orbierobot/orbierobot-firmware/hardware/v5/out/orbie_v5_body.top.png

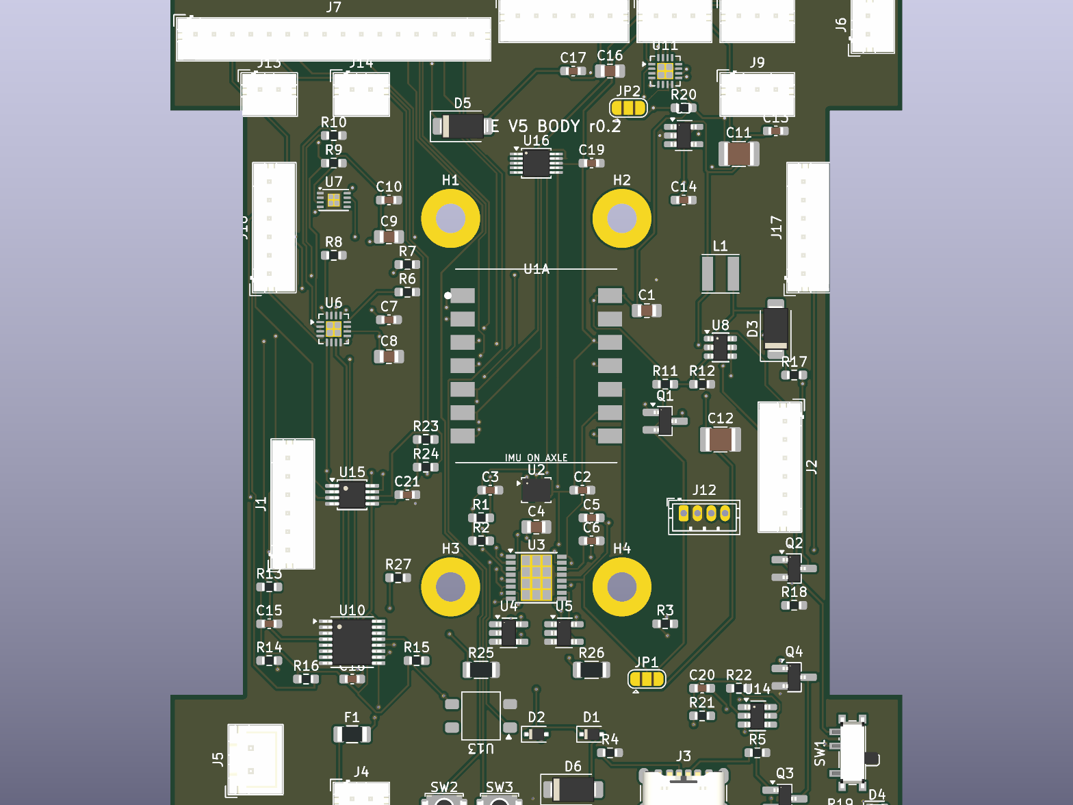
hardware/v5/out/orbie_v5_body.top.png
