orbierobot/orbierobot-firmware/hardware/v5/out/orbie_v5_dock.bottom.png

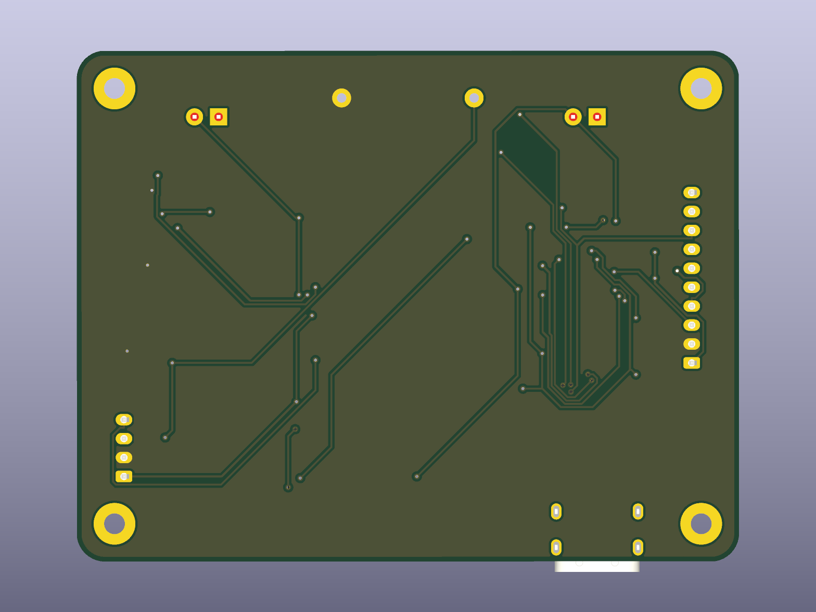
hardware/v5/out/orbie_v5_dock.bottom.png
