orbierobot/orbierobot-firmware/hardware/v5/out/orbie_v5_water.bottom.png

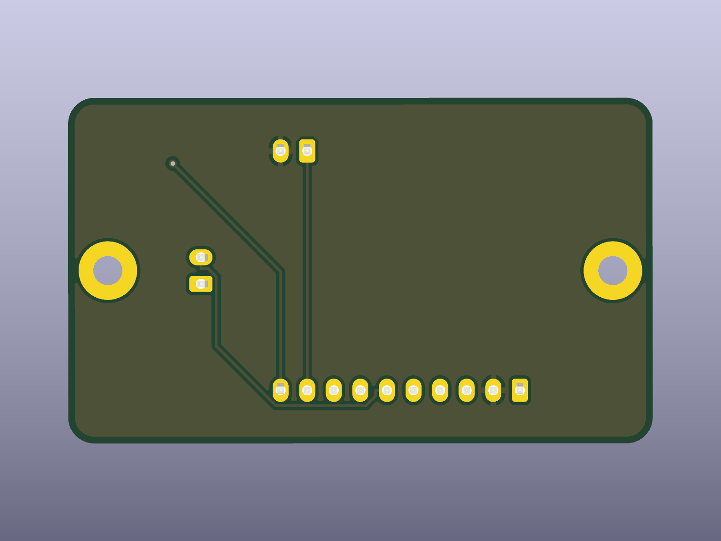
hardware/v5/out/orbie_v5_water.bottom.png
