orbierobot/orbierobot-firmware/hardware/v5/orbie_v5_dock_bom.csv

Ref | Value | Symbol | Footprint | Side | Description
U1A | XIAO_ESP32C3 D0-D6 | Connector:Conn_01x07_Pin | orbie_v5:XIAO_Castellated | F | XIAO ESP32-C3 left row
U1B | XIAO_ESP32C3 D7-D10,3V3,GND,5V | Connector:Conn_01x07_Pin | orbie_v5:XIAO_Castellated | F | XIAO ESP32-C3 right row
C1 | 10u | Device:C | Capacitor_SMD:C_0805_2012Metric_Pad1.18x1.45mm_HandSolder | F | capacitor
J1 | USB-C 5V in | Connector:USB_C_Receptacle_PowerOnly_6P | Connector_USB:USB_C_Receptacle_GCT_USB4125-xx-x_6P_TopMnt_Horizontal | F | USB-C 6P
R1 | 5k1 | Device:R | Resistor_SMD:R_0603_1608Metric_Pad0.98x0.95mm_HandSolder | F | resistor
R2 | 5k1 | Device:R | Resistor_SMD:R_0603_1608Metric_Pad0.98x0.95mm_HandSolder | F | resistor
D1 | SMAJ5.0A TVS | Diode:SMAJ5.0A | Diode_SMD:D_SMA | F
F1 | 3A | Device:Polyfuse_Small | Fuse:Fuse_1206_3216Metric | F
C2 | 22u | Device:C | Capacitor_SMD:C_1210_3225Metric_Pad1.33x2.70mm_HandSolder | F | capacitor
Q1 | AO3401A | Transistor_FET:AO3401A | Package_TO_SOT_SMD:SOT-23_Handsoldering | F | pad high-side switch
Q2 | AO3400A | Transistor_FET:AO3400A | Package_TO_SOT_SMD:SOT-23_Handsoldering | F | level shift
R3 | 10k | Device:R | Resistor_SMD:R_0603_1608Metric_Pad0.98x0.95mm_HandSolder | F | resistor
R4 | 100k | Device:R | Resistor_SMD:R_0603_1608Metric_Pad0.98x0.95mm_HandSolder | F | resistor
R5 | 0R05 1W | Device:R | Resistor_SMD:R_2512_6332Metric | F | resistor
R6 | 100k (pads dead) | Device:R | Resistor_SMD:R_0603_1608Metric_Pad0.98x0.95mm_HandSolder | F | resistor
R7 | 10k | Device:R | Resistor_SMD:R_0603_1608Metric_Pad0.98x0.95mm_HandSolder | F | resistor
R8 | 10k | Device:R | Resistor_SMD:R_0603_1608Metric_Pad0.98x0.95mm_HandSolder | F | resistor
TP1 | POGO PIN + (P50 spring) | Connector:TestPoint | TestPoint:TestPoint_THTPad_D2.0mm_Drill1.0mm | F | spring pin, 14 mm pitch
TP2 | POGO PIN - (P50 spring) | Connector:TestPoint | TestPoint:TestPoint_THTPad_D2.0mm_Drill1.0mm | F | spring pin
D2 | IR LED 940nm L | Device:LED | LED_THT:LED_D5.0mm | F | beacon lobe
R9 | 33R 1W | Device:R | Resistor_SMD:R_1206_3216Metric | F | resistor
Q3 | MMBT2222A | Transistor_BJT:MMBT2222A | Package_TO_SOT_SMD:SOT-23_Handsoldering | F | LED driver
R11 | 1k | Device:R | Resistor_SMD:R_0603_1608Metric_Pad0.98x0.95mm_HandSolder | F | resistor
D3 | IR LED 940nm R | Device:LED | LED_THT:LED_D5.0mm | F | beacon lobe
R10 | 33R 1W | Device:R | Resistor_SMD:R_1206_3216Metric | F | resistor
Q4 | MMBT2222A | Transistor_BJT:MMBT2222A | Package_TO_SOT_SMD:SOT-23_Handsoldering | F | LED driver
R12 | 1k | Device:R | Resistor_SMD:R_0603_1608Metric_Pad0.98x0.95mm_HandSolder | F | resistor
U2 | AH1806-W | Sensor_Magnetic:AH1806-W | Package_TO_SOT_SMD:SOT-23_Handsoldering | F | hall: robot present
C3 | 100n | Device:C | Capacitor_SMD:C_0603_1608Metric_Pad1.08x0.95mm_HandSolder | F | capacitor
SW1 | FEED / PAIR | Switch:SW_Push | Button_Switch_SMD:SW_Push_1P1T_NO_CK_KMR2 | F | user button
D4 | STATUS | Device:LED | LED_SMD:LED_0603_1608Metric | F
R13 | 1k | Device:R | Resistor_SMD:R_0603_1608Metric_Pad0.98x0.95mm_HandSolder | F | resistor
U3 | DRV8833PWP | Driver_Motor:DRV8833PWP | Package_SO:HTSSOP-16-1EP_4.4x5mm_P0.65mm_EP3.4x5mm | F | feeder + pump driver
C4 | 10u | Device:C | Capacitor_SMD:C_0805_2012Metric_Pad1.18x1.45mm_HandSolder | F | capacitor
C5 | 10n | Device:C | Capacitor_SMD:C_0603_1608Metric_Pad1.08x0.95mm_HandSolder | F | capacitor
C6 | 2u2 | Device:C | Capacitor_SMD:C_0603_1608Metric_Pad1.08x0.95mm_HandSolder | F | capacitor
U4 | TCA9534PWR | Interface_Expansion:TCA9534 | Package_SO:TSSOP-16_4.4x5mm_P0.65mm | F | expander: motor inputs + module present
C7 | 100n | Device:C | Capacitor_SMD:C_0603_1608Metric_Pad1.08x0.95mm_HandSolder | F | capacitor
R14 | 2k2 | Device:R | Resistor_SMD:R_0603_1608Metric_Pad0.98x0.95mm_HandSolder | F | resistor
R15 | 2k2 | Device:R | Resistor_SMD:R_0603_1608Metric_Pad0.98x0.95mm_HandSolder | F | resistor
J2 | STACK BUS 10p | Connector:Conn_01x10_Pin | Connector_JST:JST_PH_B10B-PH-K_1x10_P2.00mm_Vertical | F | to feeder / water modules (spring contacts on the deck)
R16 | 10k | Device:R | Resistor_SMD:R_0603_1608Metric_Pad0.98x0.95mm_HandSolder | F | resistor
R17 | 10k | Device:R | Resistor_SMD:R_0603_1608Metric_Pad0.98x0.95mm_HandSolder | F | resistor
R18 | 10k | Device:R | Resistor_SMD:R_0603_1608Metric_Pad0.98x0.95mm_HandSolder | F | resistor
R19 | 10k | Device:R | Resistor_SMD:R_0603_1608Metric_Pad0.98x0.95mm_HandSolder | F | resistor
J3 | BUS UART (opt. smart module) | Connector:Conn_01x04_Pin | Connector_JST:JST_PH_B4B-PH-K_1x04_P2.00mm_Vertical | F | optional
