orbierobot/orbierobot-firmware/hardware/v5/out/orbie_v5_pogo_bom_jlc.csv

Comment | Designator | Footprint | LCSC Part # | Qty
POGO+ D6 | PAD1 | PogoPad_D6mm |  | 1
POGO- D6 | PAD2 | PogoPad_D6mm |  | 1
to J4 body | J1 | JST_PH_B2B-PH-K_1x02_P2.00mm_Vertical |  | 1
