orbierobot/orbierobot-firmware/hardware/v5/out/orbie_v5_body.sch.pdf

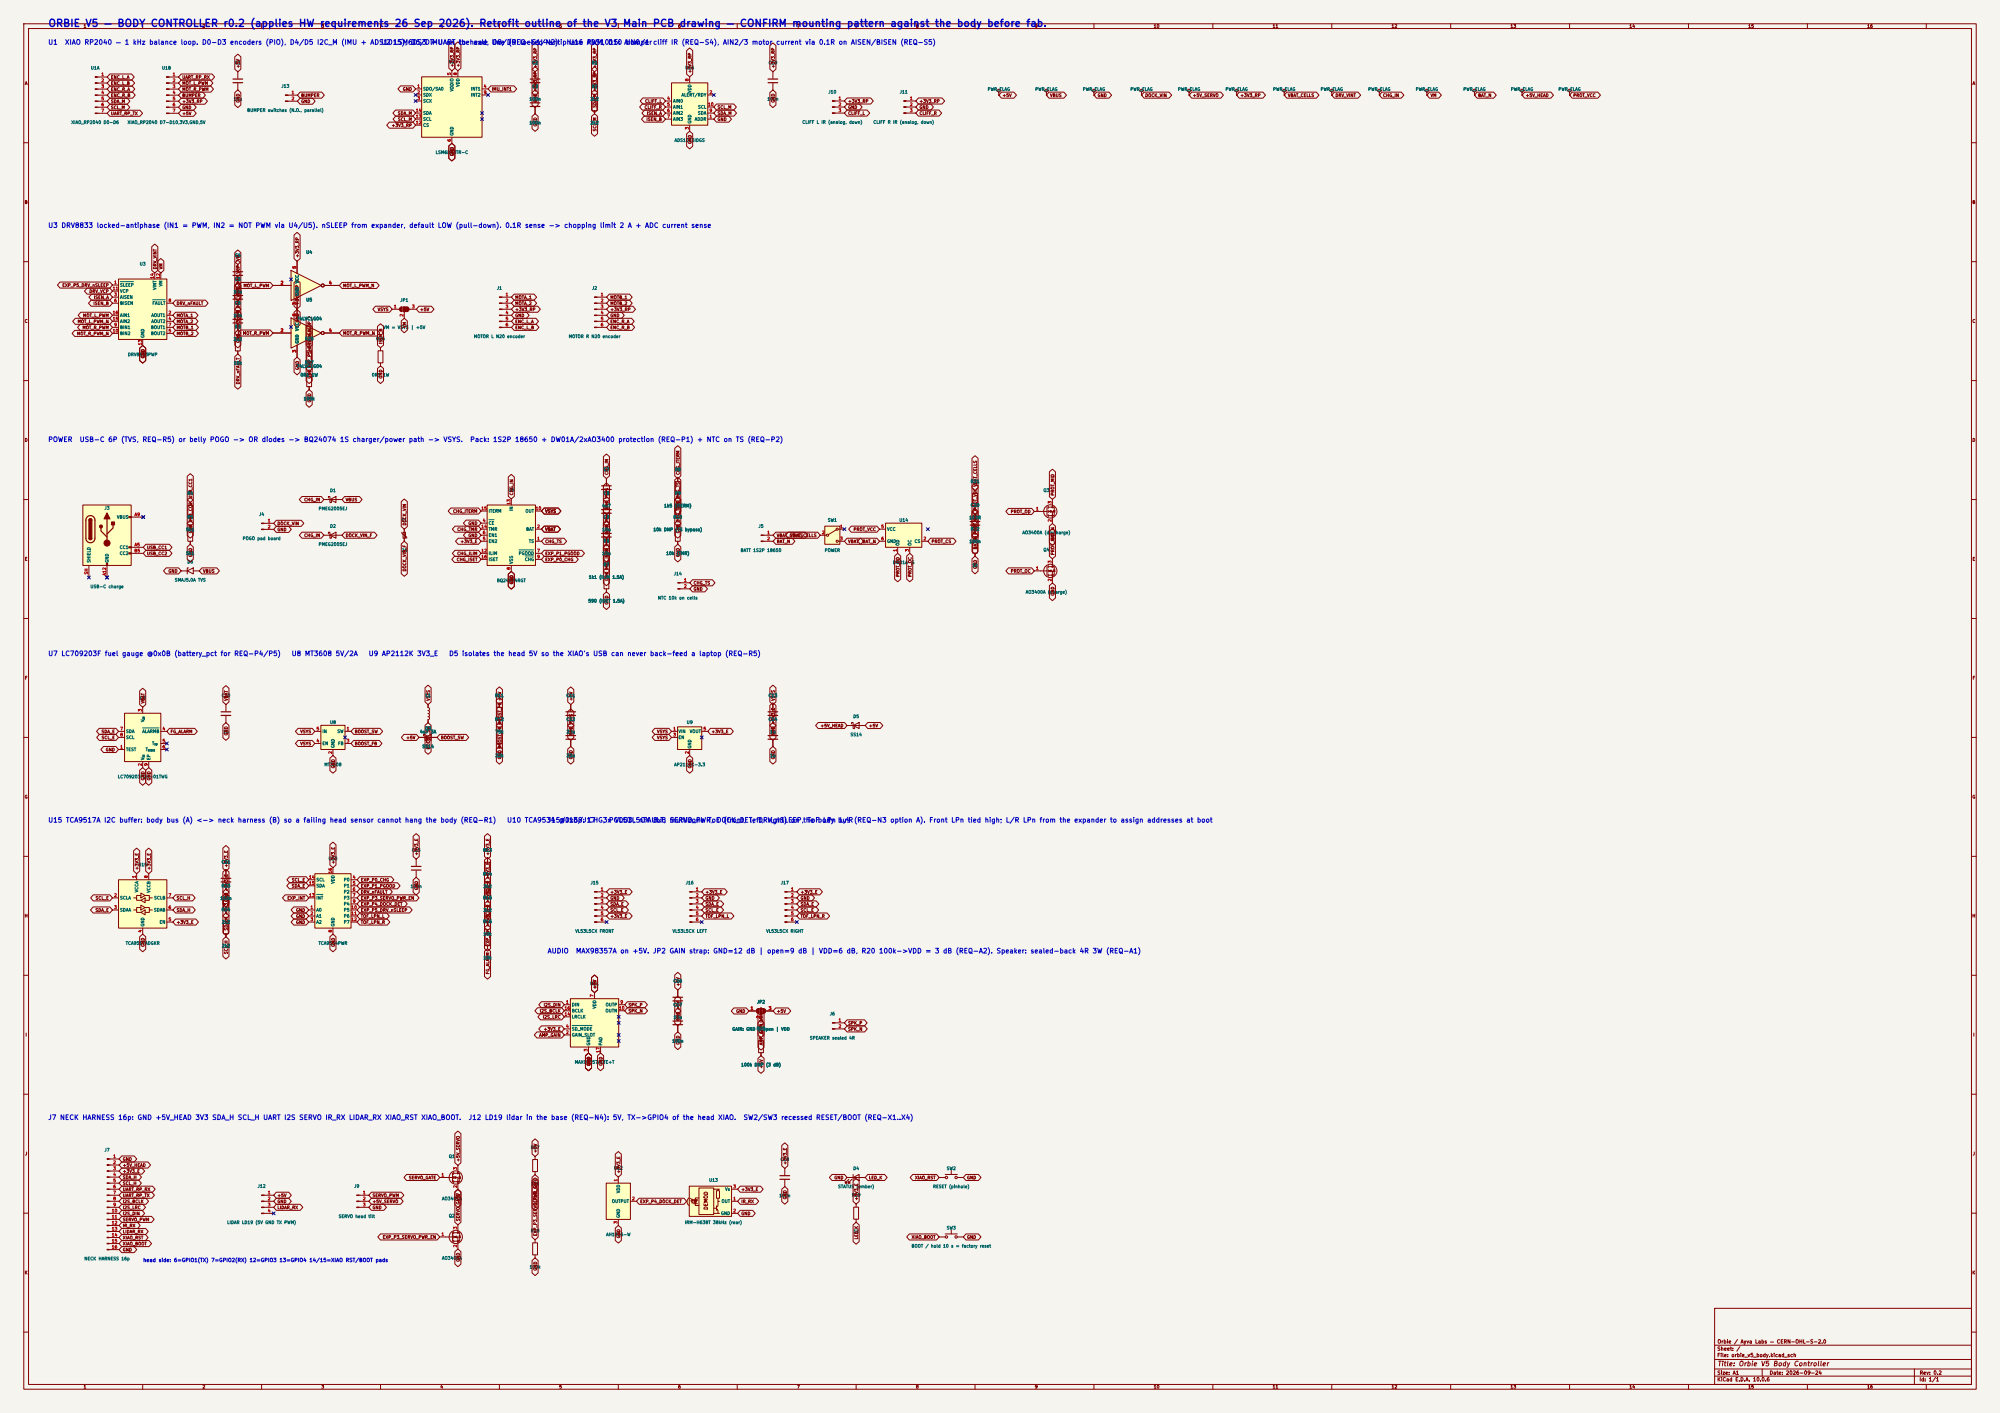
[picture p18: page 1]

ORBIE V5 — BODY CONTROLLER r0.2 (applies HW requirements 26 Sep 2026). Retrofit outline of the V3 Main PCB drawing — CONFIRM mounting pattern against the body before fab.
SPK_N +3V3_RP

U1 XIAO RP2040 — 1 kHz balance loop. D0-D3 encoders (PIO), D4/D5 I2C_M (IMU + ADS1015), D6/D7 UART to head, D8/D9 locked-antiphase PWM, D10 bumper

J11 CLIFF R IR (analog, down)

U3 DRV8833 locked-antiphase (IN1 = PWM, IN2 = NOT PWM via U4/U5). nSLEEP from expander, default LOW (pull-down). 0.1R sense -> chopping limit 2 A + ADC current sense

POWER USB-C 6P (TVS, REQ-R5) or belly POGO -> OR diodes -> BQ24074 1S charger/power path -> VSYS. Pack: 1S2P 18650 + DW01A/2xAO3400 protection (REQ-P1) + NTC on TS (REQ-P2)

J15/J16/J17 3x VL53L5CX 8x8 multizone ToF (front, left, right) on the body bus (REQ-N3 option A). Front LPn tied high; L/R LPn from the expander to assign addresses at boot

AUDIO MAX98357A on +5V. JP2 GAIN strap: GND=12 dB | open=9 dB | VDD=6 dB, R20 100k->VDD = 3 dB (REQ-A2). Speaker: sealed-back 4R 3W (REQ-A1)

JP2 GAIN: GND | open | VDD

J7 NECK HARNESS 16p: GND +5V_HEAD 3V3 SDA_H SCL_H UART I2S SERVO IR_RX LIDAR_RX XIAO_RST XIAO_BOOT. J12 LD19 lidar in the base (REQ-N4): 5V, TX->GPIO4 of the head XIAO. SW2/SW3 recessed RESET/BOOT (REQ-X1..X4)

head side: 6=GPIO1(TX) 7=GPIO2(RX) 12=GPIO3 13=GPIO4 14/15=XIAO RST/BOOT pads

Orbie / Ayva Labs — CERN-OHL-S-2.0
Sheet: /
File: orbie_v5_body.kicad_sch
Title: Orbie V5 Body Controller

Size: A1 | Rev: 0.2
KiCad E.D.A. 10.0.6 | Id: 1/1
