orbierobot/orbierobot-firmware/hardware/v5/out/orbie_v5_feeder.sch.pdf

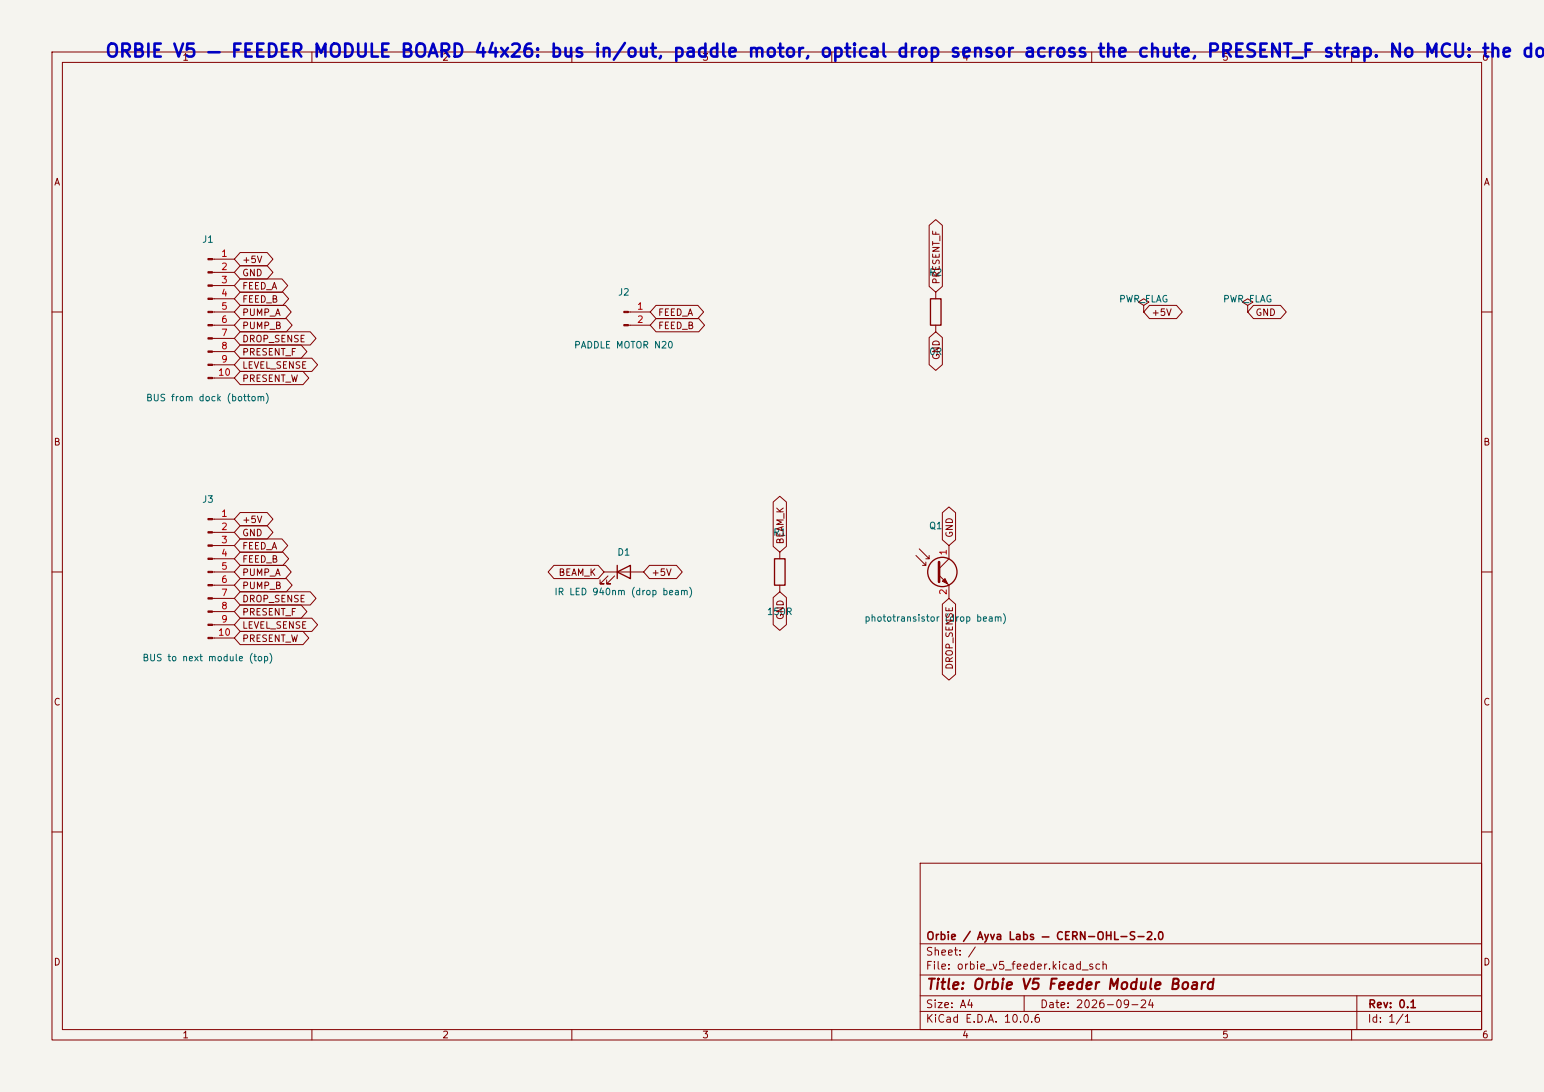
[picture p20: page 1]

PRESENT_F ORBIE V5 — FEEDER MODULE BOARD 44x26: bus in/out, paddle motor, optical drop sensor across the chute, PRESENT_F strap. No MCU: the dock runs it (REQ-D3).
J1 BUS from dock (bottom) 1

Orbie / Ayva Labs — CERN-OHL-S-2.0
Sheet: /
File: orbie_v5_feeder.kicad_sch
Title: Orbie V5 Feeder Module Board

Size: A4 | Rev: 0.1
KiCad E.D.A. 10.0.6 | Id: 1/1
