orbierobot/orbierobot-firmware/hardware/v5/out/orbie_v5_pogo.sch.pdf

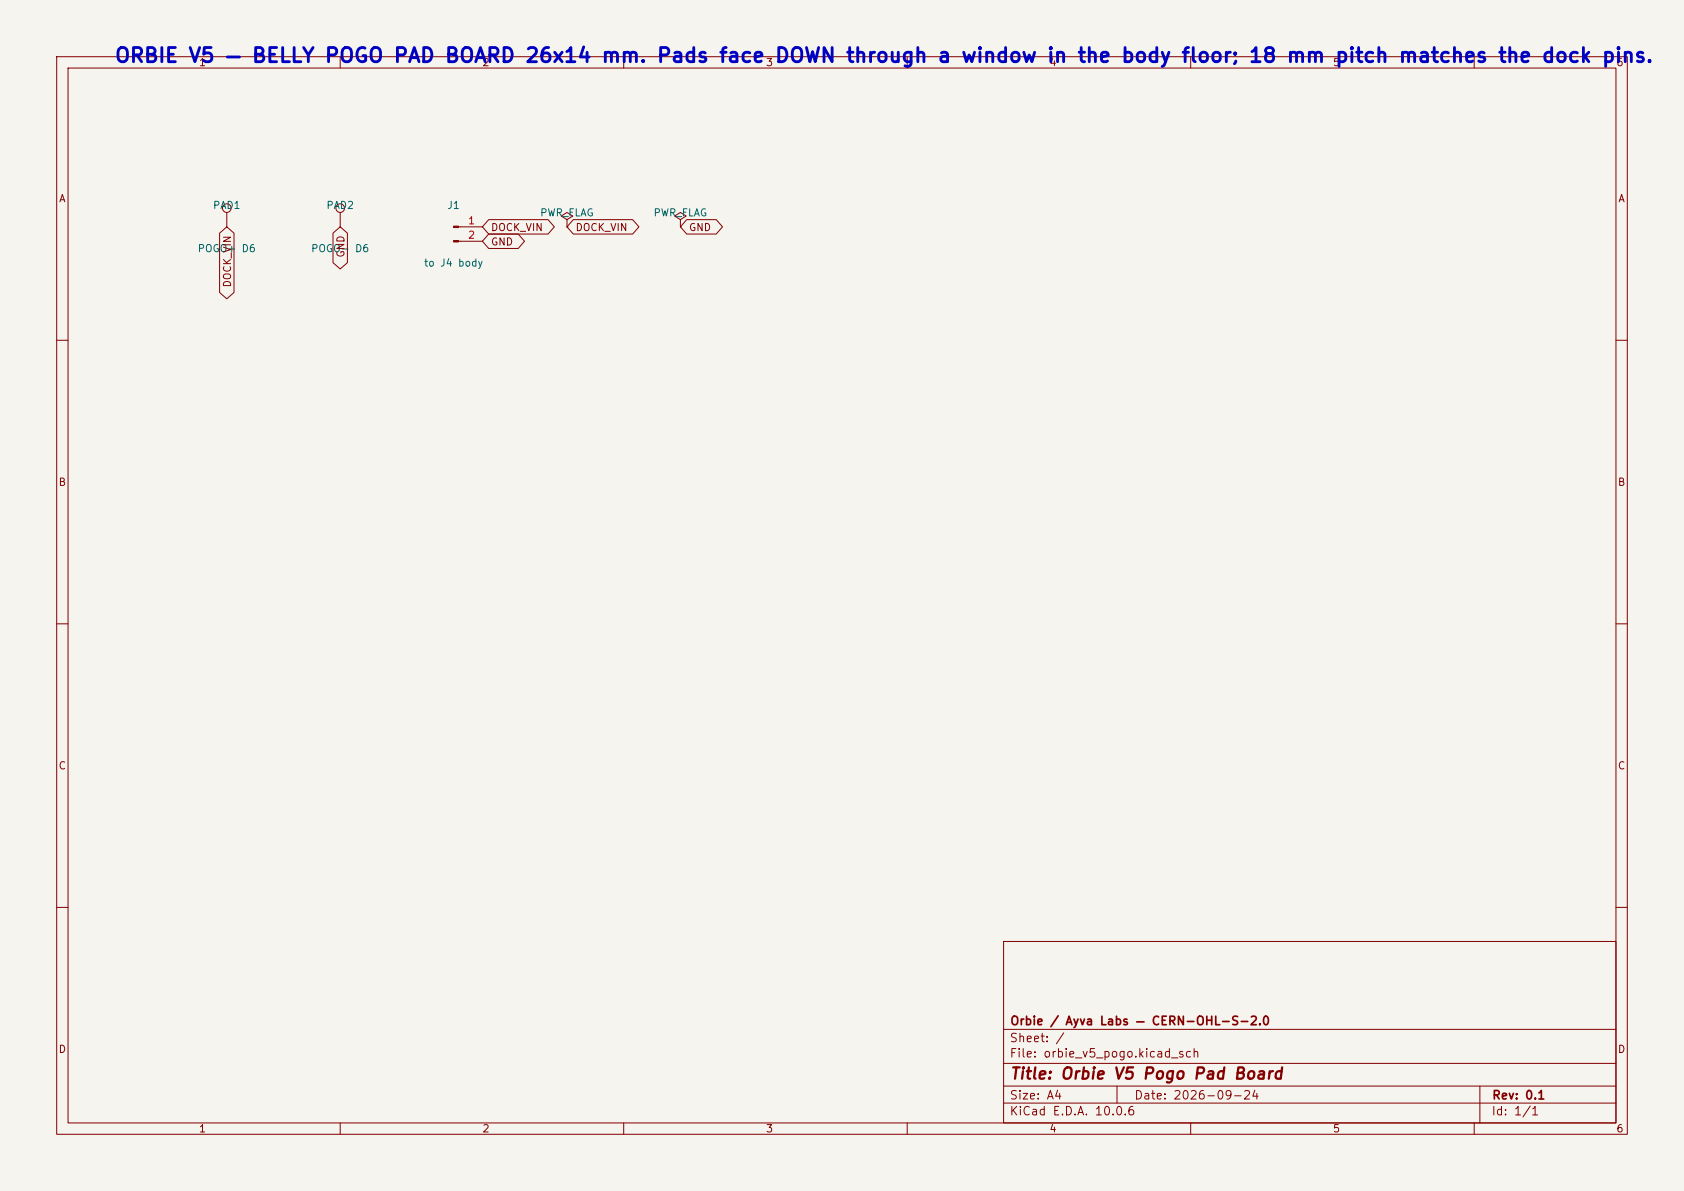
[picture p21: page 1]

ORBIE V5 — BELLY POGO PAD BOARD 26x14 mm. Pads face DOWN through a window in the body floor; 18 mm pitch matches the dock pins.

Orbie / Ayva Labs — CERN-OHL-S-2.0
Sheet: /
File: orbie_v5_pogo.kicad_sch
Title: Orbie V5 Pogo Pad Board

Size: A4 | Rev: 0.1
KiCad E.D.A. 10.0.6 | Id: 1/1
