orbierobot/orbierobot-firmware/hardware/v5/out/orbie_v5_water.sch.pdf

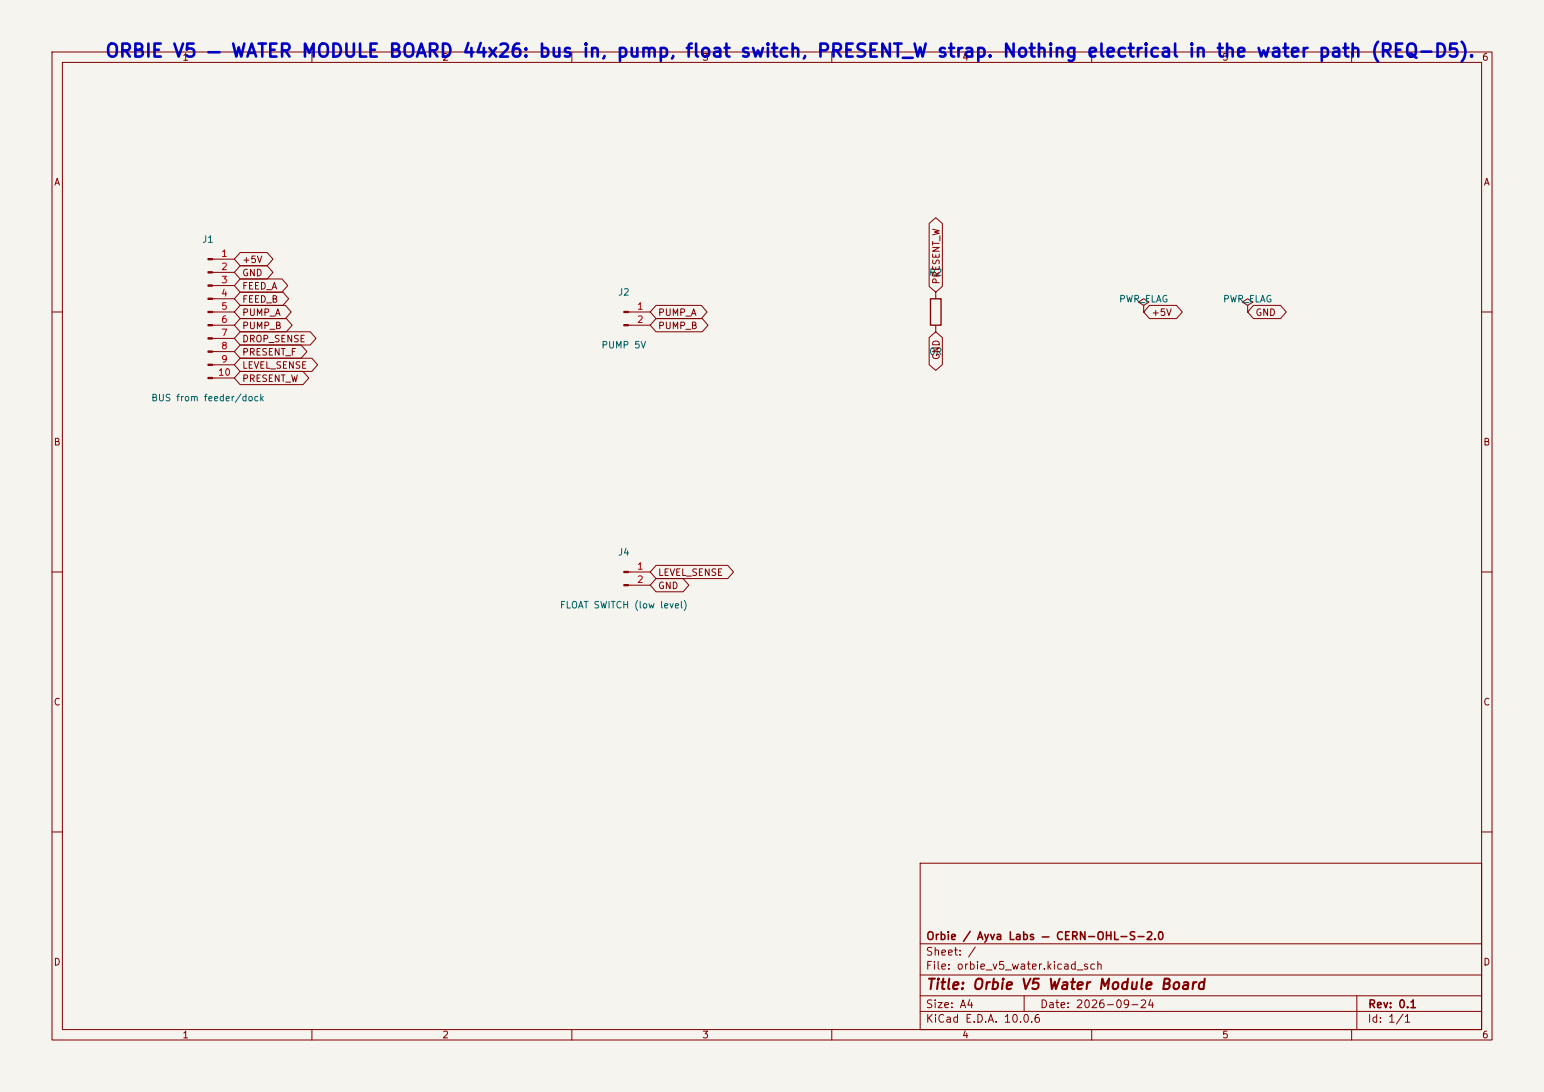
[picture p22: page 1]

GND ORBIE V5 — WATER MODULE BOARD 44x26: bus in, pump, float switch, PRESENT_W strap. Nothing electrical in the water path (REQ-D5).

Orbie / Ayva Labs — CERN-OHL-S-2.0
Sheet: /
File: orbie_v5_water.kicad_sch
Title: Orbie V5 Water Module Board

Size: A4 | Rev: 0.1
KiCad E.D.A. 10.0.6 | Id: 1/1
