orbierobot/orbierobot-firmware/hardware/v5/orbie_v5_dock.kicad_pcb

## KiCad design hardware/v5/orbie_v5_dock.kicad_pcb (2026-10-01)

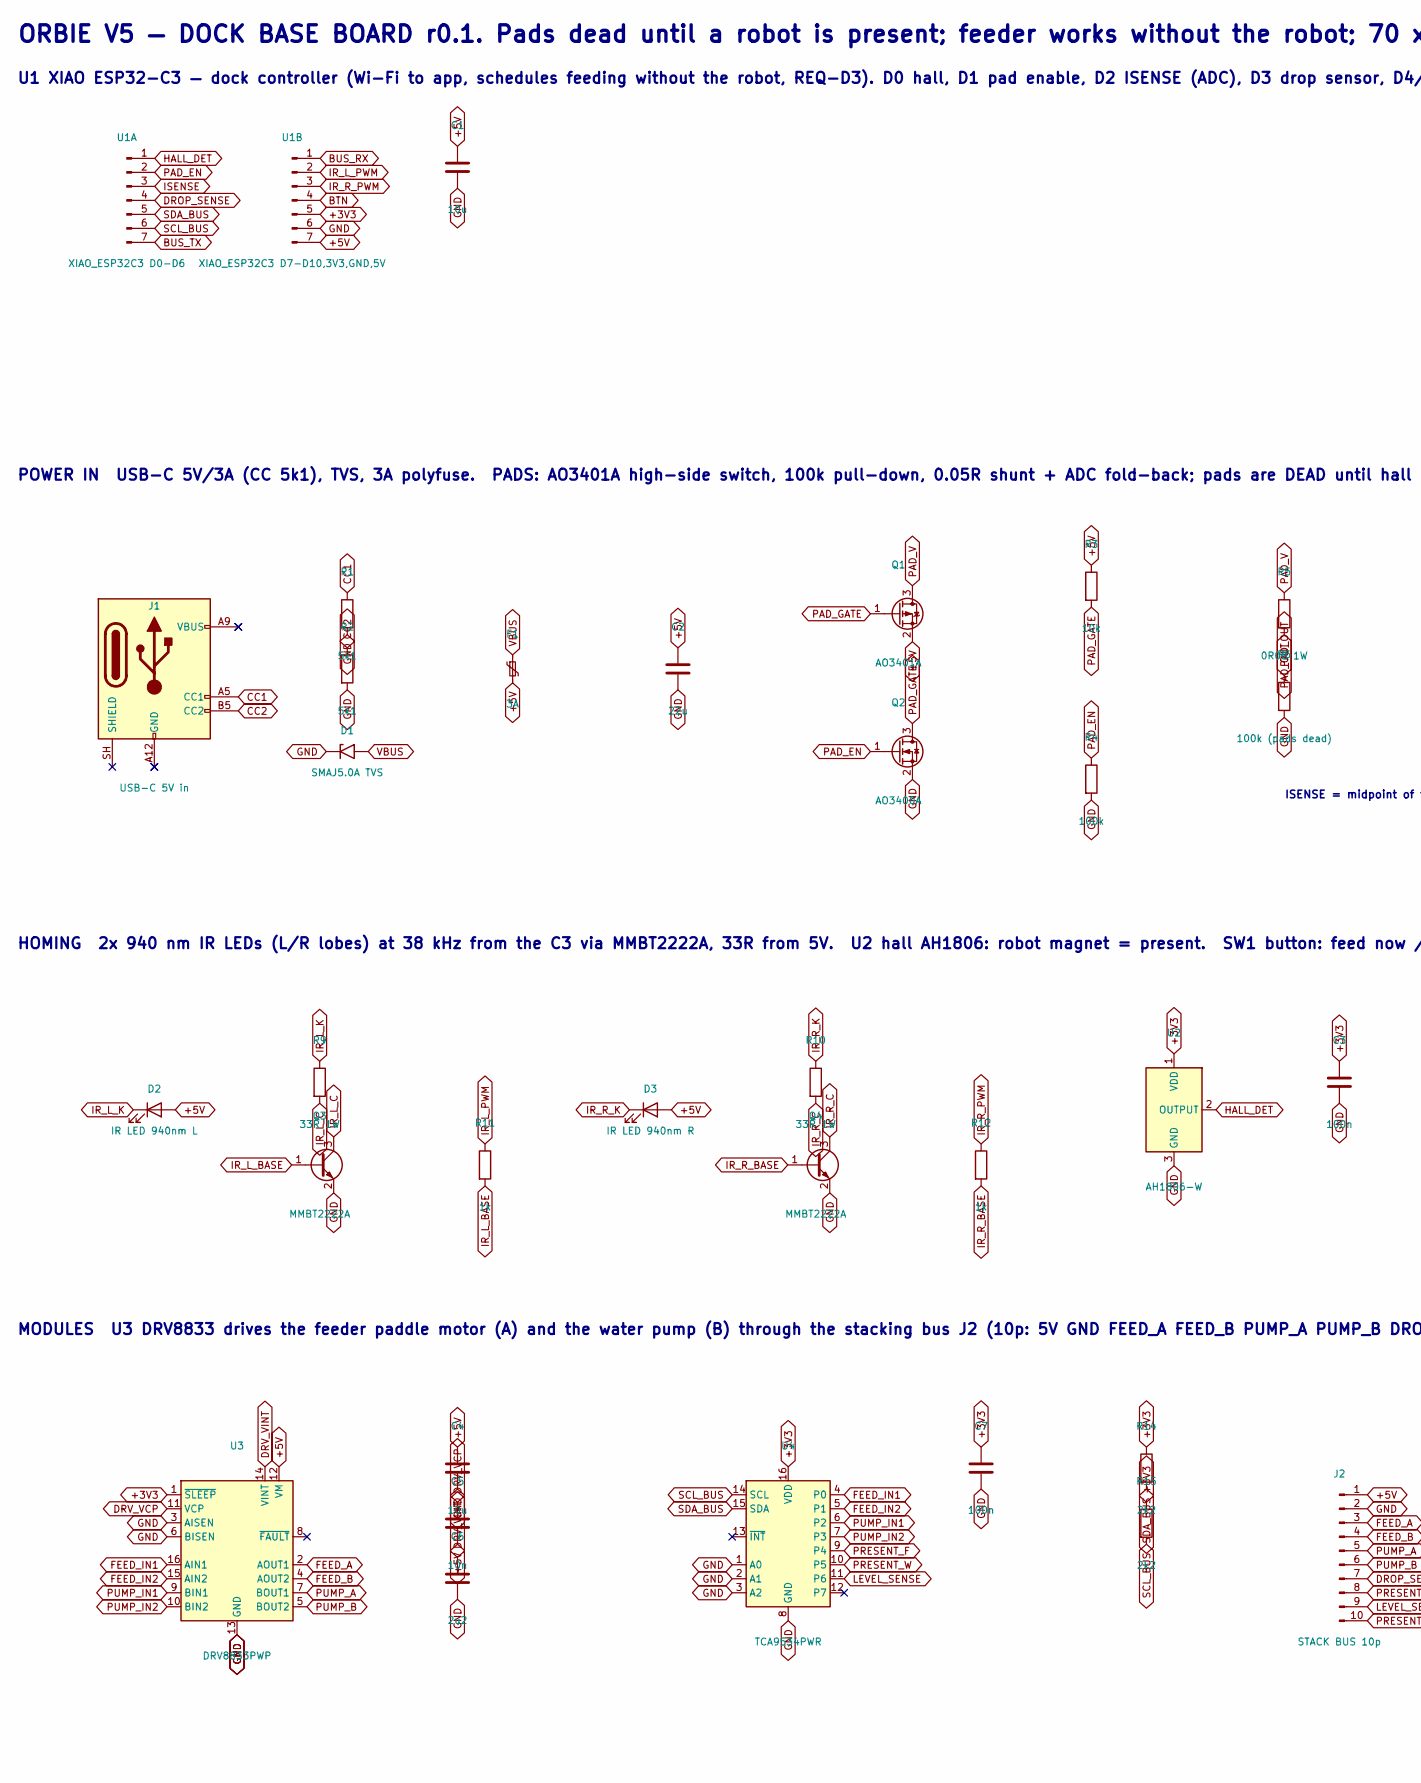
[picture p23: schematic orbie_v5_dock.kicad_sch, Orbie V5 Dock Base Board, part in row 1, column 1]

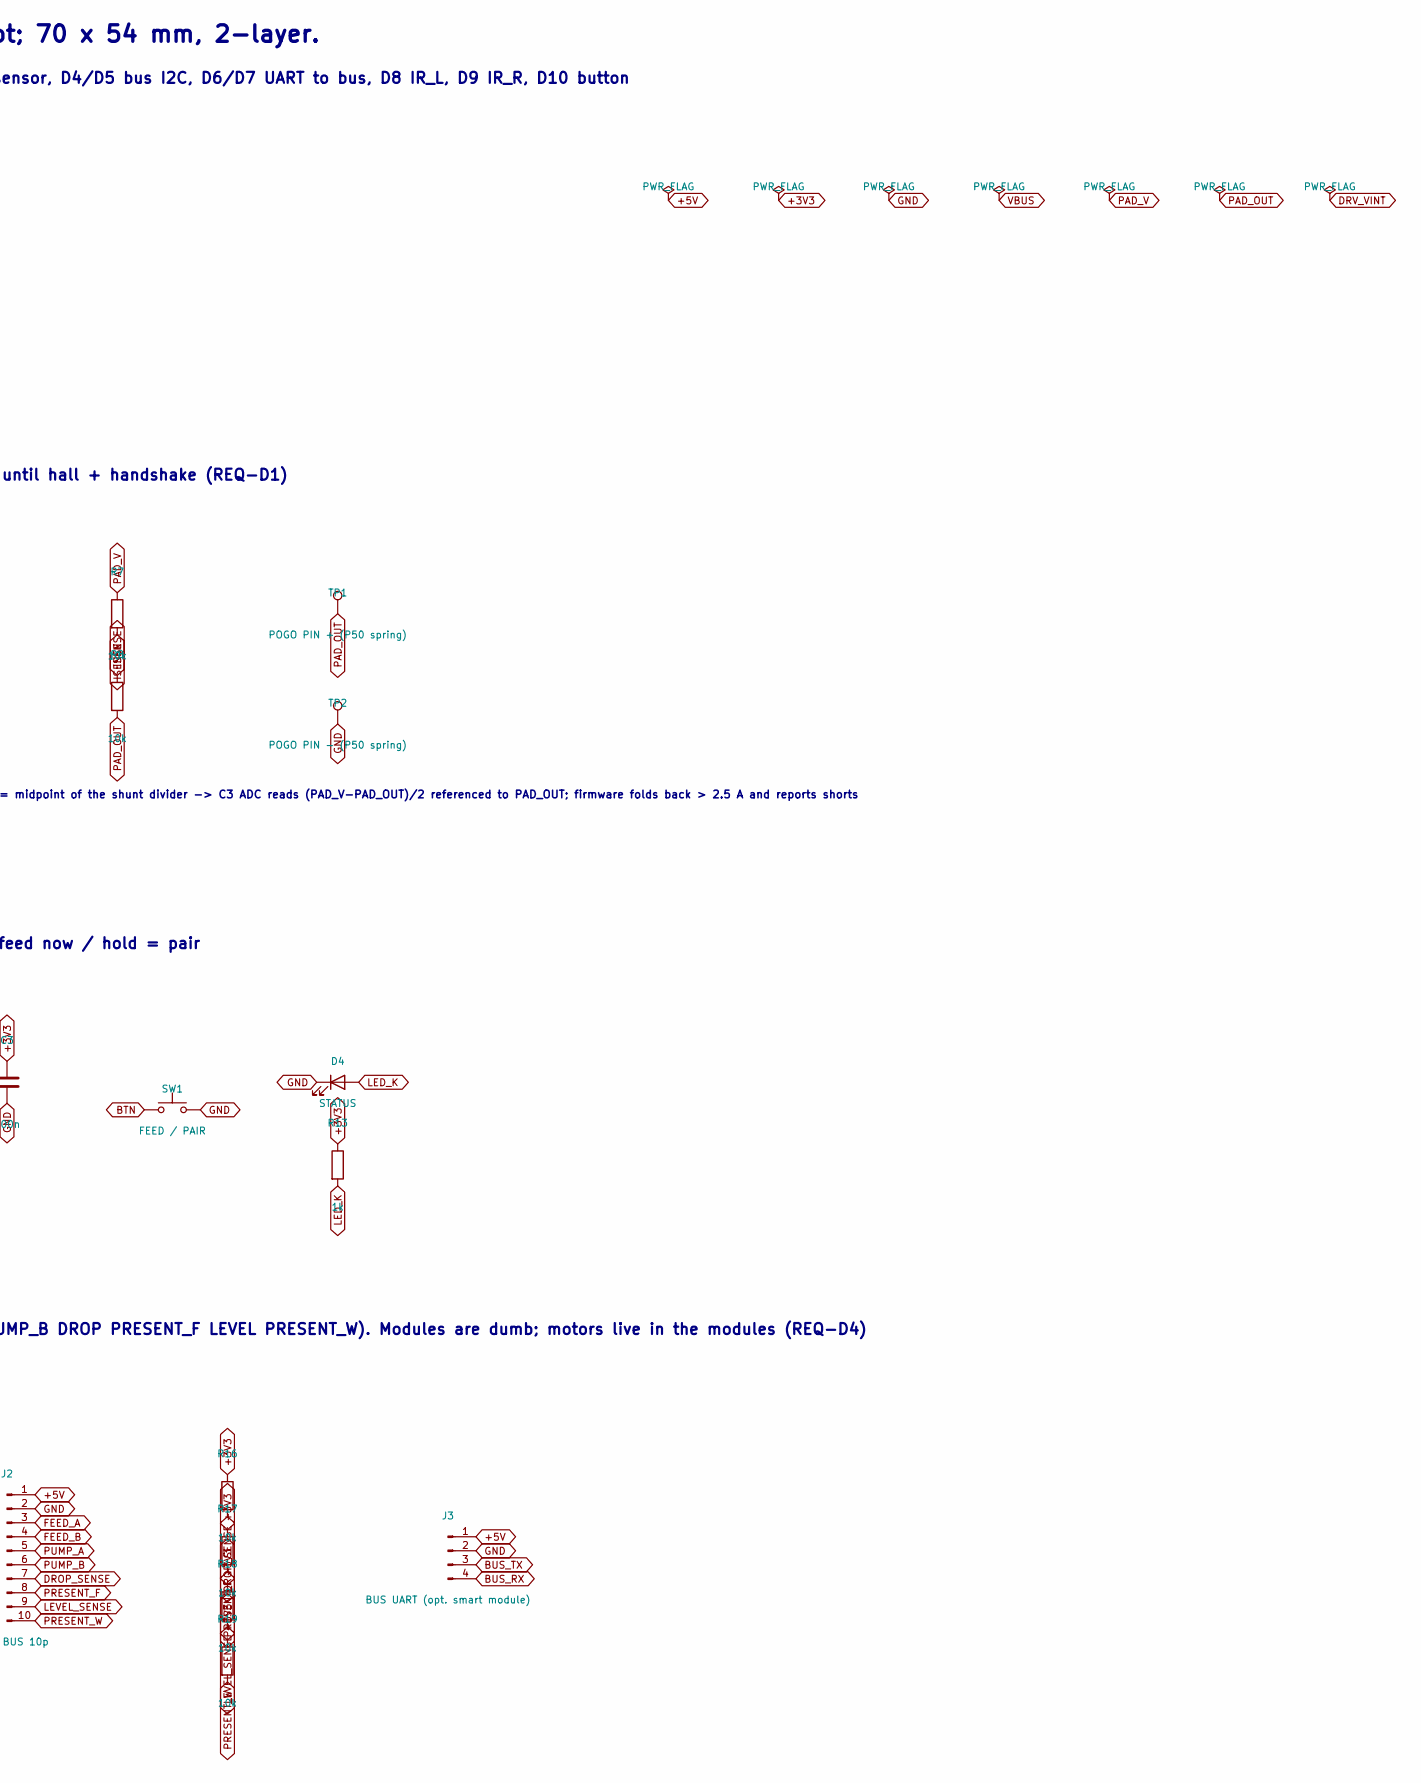
[picture p24: schematic orbie_v5_dock.kicad_sch, Orbie V5 Dock Base Board, part in row 1, column 2]

Parts:
C1, C4: 10u; C_0805_2012Metric_Pad1.18x1.45mm_HandSolder
C2: 22u; C_1210_3225Metric_Pad1.33x2.70mm_HandSolder
C3, C7: 100n; C_0603_1608Metric_Pad1.08x0.95mm_HandSolder
C5: 10n; C_0603_1608Metric_Pad1.08x0.95mm_HandSolder
C6: 2u2; C_0603_1608Metric_Pad1.08x0.95mm_HandSolder
D1: SMAJ5.0A TVS; D_SMA
D2: IR LED 940nm L; LED_D5.0mm
D3: IR LED 940nm R; LED_D5.0mm
D4: STATUS; LED_0603_1608Metric
F1: 3A; Fuse_1206_3216Metric
J1: USB-C 5V in; USB_C_Receptacle_GCT_USB4125-xx-x_6P_TopMnt_Horizontal
J2: STACK BUS 10p; JST_PH_B10B-PH-K_1x10_P2.00mm_Vertical
J3: BUS UART (opt. smart module); JST_PH_B4B-PH-K_1x04_P2.00mm_Vertical
Q1: AO3401A; SOT-23_Handsoldering
Q2: AO3400A; SOT-23_Handsoldering
Q3, Q4: MMBT2222A; SOT-23_Handsoldering
R1, R2: 5k1; R_0603_1608Metric_Pad0.98x0.95mm_HandSolder
R3, R7, R8, R16, R17, R18, R19: 10k; R_0603_1608Metric_Pad0.98x0.95mm_HandSolder
R4: 100k; R_0603_1608Metric_Pad0.98x0.95mm_HandSolder
R5: 0R05 1W; R_2512_6332Metric
R6: 100k (pads dead); R_0603_1608Metric_Pad0.98x0.95mm_HandSolder
R9, R10: 33R 1W; R_1206_3216Metric
R11, R12, R13: 1k; R_0603_1608Metric_Pad0.98x0.95mm_HandSolder
R14, R15: 2k2; R_0603_1608Metric_Pad0.98x0.95mm_HandSolder
SW1: FEED / PAIR; SW_Push_1P1T_NO_CK_KMR2
TP1: POGO PIN + (P50 spring); TestPoint_THTPad_D2.0mm_Drill1.0mm
TP2: POGO PIN - (P50 spring); TestPoint_THTPad_D2.0mm_Drill1.0mm
U1A: XIAO_ESP32C3 D0-D6; XIAO_Castellated
U1B: XIAO_ESP32C3 D7-D10,3V3,GND,5V; XIAO_Castellated
U2: AH1806-W; SOT-23_Handsoldering
U3: DRV8833PWP; HTSSOP-16-1EP_4.4x5mm_P0.65mm_EP3.4x5mm
U4: TCA9534PWR; TSSOP-16_4.4x5mm_P0.65mm

Connections:
+3V3: C3.1, C7.1, R13.1, R14.1, R15.1, R16.1, R17.1, R18.1, R19.1, U1A.12, U1B.5, U2.1 (VDD), U3.1 (~SLEEP), U4.16 (VDD)
+5V: C1.1, C2.1, C4.1, C5.2, D2.2 (A), D3.2 (A), F1.2, J2.1, J3.1, Q1.2 (S), R3.1, U1A.14, U1B.7, U3.12 (VM)
BTN: SW1.1, U1A.11, U1B.4
BUS_RX: J3.4, U1A.8, U1B.1
BUS_TX: J3.3, U1A.7
CC1: J1.A5 (CC1), R1.1
CC2: J1.B5 (CC2), R2.1
DROP_SENSE: J2.7, R16.2, U1A.4
DRV_VCP: C5.1, U3.11 (VCP)
DRV_VINT: C6.1, U3.14 (VINT)
FEED_A: J2.3, U3.2 (AOUT1)
FEED_B: J2.4, U3.4 (AOUT2)
FEED_IN1: U3.16 (AIN1), U4.4 (P0)
FEED_IN2: U3.15 (AIN2), U4.5 (P1)
GND: C1.2, C2.2, C3.2, C4.2, C6.2, C7.2, D1.1 (A1), D4.1 (K), J2.2, J3.2, Q2.2 (S), Q3.2 (E), Q4.2 (E), R1.2, R2.2, R4.2, R6.2, SW1.2, TP2.1, U1A.13, U1B.6, U2.3 (GND), U3.3 (AISEN), U3.6 (BISEN), U3.13 (GND), U3.17 (GND), U4.1 (A0), U4.2 (A1), U4.3 (A2), U4.8 (GND)
HALL_DET: U1A.1, U2.2 (OUTPUT)
IR_L_BASE: Q3.1 (B), R11.2
IR_L_C: Q3.3 (C), R9.2
IR_L_K: D2.1 (K), R9.1
IR_L_PWM: R11.1, U1A.9, U1B.2
IR_R_BASE: Q4.1 (B), R12.2
IR_R_C: Q4.3 (C), R10.2
IR_R_K: D3.1 (K), R10.1
IR_R_PWM: R12.1, U1A.10, U1B.3
ISENSE: R7.2, R8.1, U1A.3
LED_K: D4.2 (A), R13.2
LEVEL_SENSE: J2.9, R18.2, U4.11 (P6)
PAD_EN: Q2.1 (G), R4.1, U1A.2
PAD_GATE: Q1.1 (G), Q2.3 (D), R3.2
PAD_OUT: R5.2, R6.1, R8.2, TP1.1
PAD_V: Q1.3 (D), R5.1, R7.1
PRESENT_F: J2.8, R17.2, U4.9 (P4)
PRESENT_W: J2.10, R19.2, U4.10 (P5)
PUMP_A: J2.5, U3.7 (BOUT1)
PUMP_B: J2.6, U3.5 (BOUT2)
PUMP_IN1: U3.9 (BIN1), U4.6 (P2)
PUMP_IN2: U3.10 (BIN2), U4.7 (P3)
SCL_BUS: R15.2, U1A.6, U4.14 (SCL)
SDA_BUS: R14.2, U1A.5, U4.15 (SDA)
VBUS: D1.2 (A2), F1.1

Notes on the sheet:
ORBIE V5 — DOCK BASE BOARD r0.1. Pads dead until a robot is present; feeder works without the robot; 70 x 54 mm, 2-layer.
U1 XIAO ESP32-C3 — dock controller (Wi-Fi to app, schedules feeding without the robot, REQ-D3). D0 hall, D1 pad enable, D2 ISENSE (ADC), D3 drop sensor, D4/D5 bus I2C, D6/D7 UART to bus, D8 IR_L, D9 IR_R, D10 button
POWER IN USB-C 5V/3A (CC 5k1), TVS, 3A polyfuse. PADS: AO3401A high-side switch, 100k pull-down, 0.05R shunt + ADC fold-back; pads are DEAD until hall + handshake (REQ-D1)
ISENSE = midpoint of the shunt divider -> C3 ADC reads (PAD_V-PAD_OUT)/2 referenced to PAD_OUT; firmware folds back > 2.5 A and reports shorts
HOMING 2x 940 nm IR LEDs (L/R lobes) at 38 kHz from the C3 via MMBT2222A, 33R from 5V. U2 hall AH1806: robot magnet = present. SW1 button: feed now / hold = pair
MODULES U3 DRV8833 drives the feeder paddle motor (A) and the water pump (B) through the stacking bus J2 (10p: 5V GND FEED_A FEED_B PUMP_A PUMP_B DROP PRESENT_F LEVEL PRESENT_W). Modules are dumb; motors live in the modules (REQ-D4)

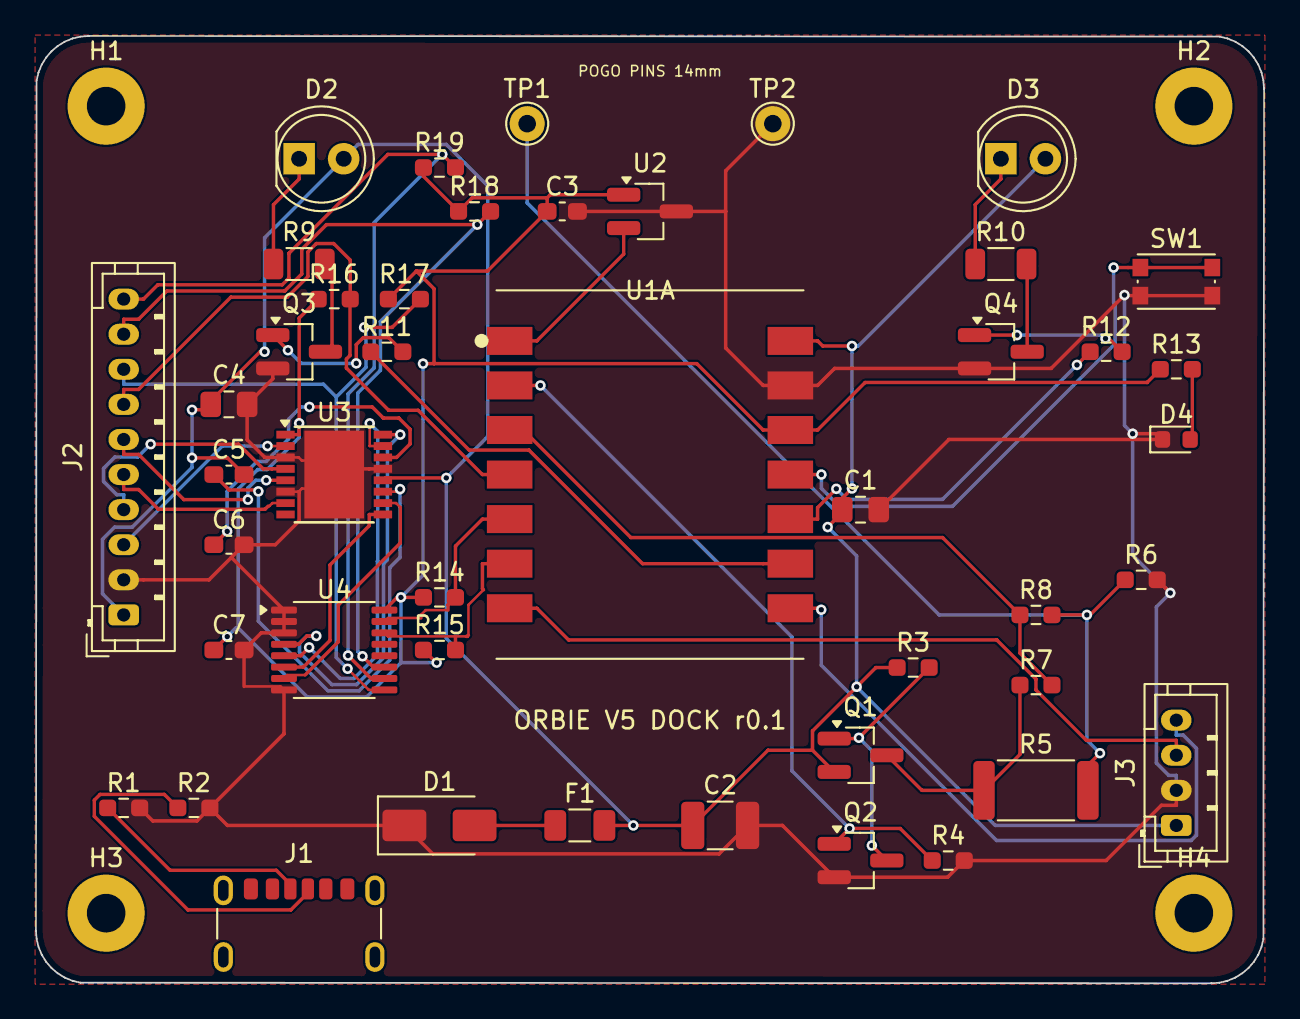
[picture p25: board orbie_v5_dock.kicad_pcb from above]

Board: 2 copper layers, 70.0 x 54.0 mm, 49 parts (0 on the bottom side), 40 nets.

Other parts of the board:
H1, H2, H3, H4: MountingHole_2.2mm_M2_Pad
