orbierobot/orbierobot-firmware/hardware/v5/orbie_v5_feeder.kicad_pcb

## KiCad design hardware/v5/orbie_v5_feeder.kicad_pcb (2026-10-01)

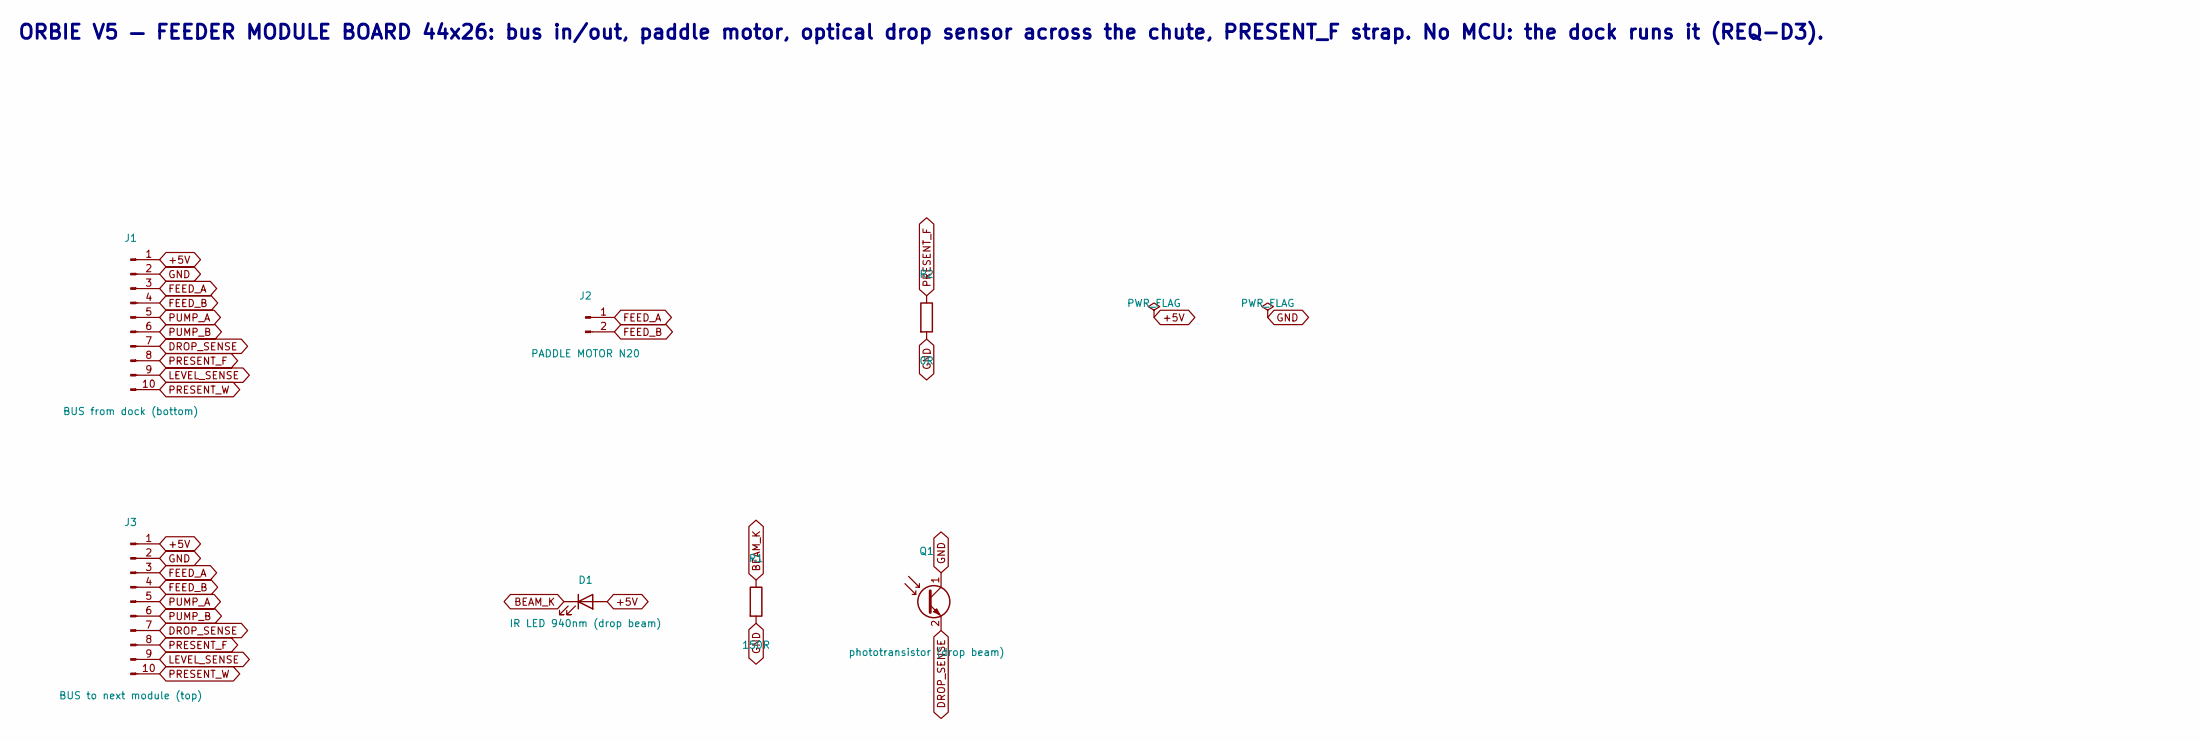
[picture p26: schematic orbie_v5_feeder.kicad_sch, Orbie V5 Feeder Module Board]

Parts:
D1: IR LED 940nm (drop beam); LED_D3.0mm
J1: BUS from dock (bottom); JST_PH_B10B-PH-K_1x10_P2.00mm_Vertical
J2: PADDLE MOTOR N20; JST_PH_B2B-PH-K_1x02_P2.00mm_Vertical
J3: BUS to next module (top); JST_PH_B10B-PH-K_1x10_P2.00mm_Vertical
Q1: phototransistor (drop beam); LED_D3.0mm
R1: 150R; R_0603_1608Metric_Pad0.98x0.95mm_HandSolder
R2: 0R; R_0603_1608Metric_Pad0.98x0.95mm_HandSolder

Connections:
+5V: D1.2 (A), J1.1, J3.1
BEAM_K: D1.1 (K), R1.1
DROP_SENSE: J1.7, J3.7, Q1.2 (E)
FEED_A: J1.3, J2.1, J3.3
FEED_B: J1.4, J2.2, J3.4
GND: J1.2, J3.2, Q1.1 (C), R1.2, R2.2
LEVEL_SENSE: J1.9, J3.9
PRESENT_F: J1.8, J3.8, R2.1
PRESENT_W: J1.10, J3.10
PUMP_A: J1.5, J3.5
PUMP_B: J1.6, J3.6

Notes on the sheet:
ORBIE V5 — FEEDER MODULE BOARD 44x26: bus in/out, paddle motor, optical drop sensor across the chute, PRESENT_F strap. No MCU: the dock runs it (REQ-D3).

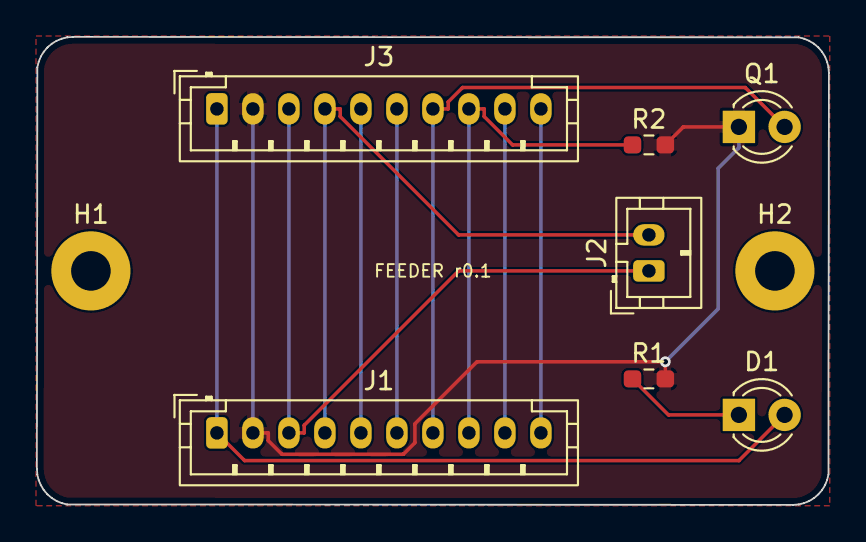
[picture p27: board orbie_v5_feeder.kicad_pcb from above]

Board: 2 copper layers, 44.0 x 26.0 mm, 9 parts (0 on the bottom side), 11 nets.

Other parts of the board:
H1, H2: MountingHole_2.2mm_M2_Pad
