orbierobot/orbierobot-firmware/hardware/v5/orbie_v5_body.kicad_pcb

## KiCad design hardware/v5/orbie_v5_body.kicad_pcb (2026-10-01)

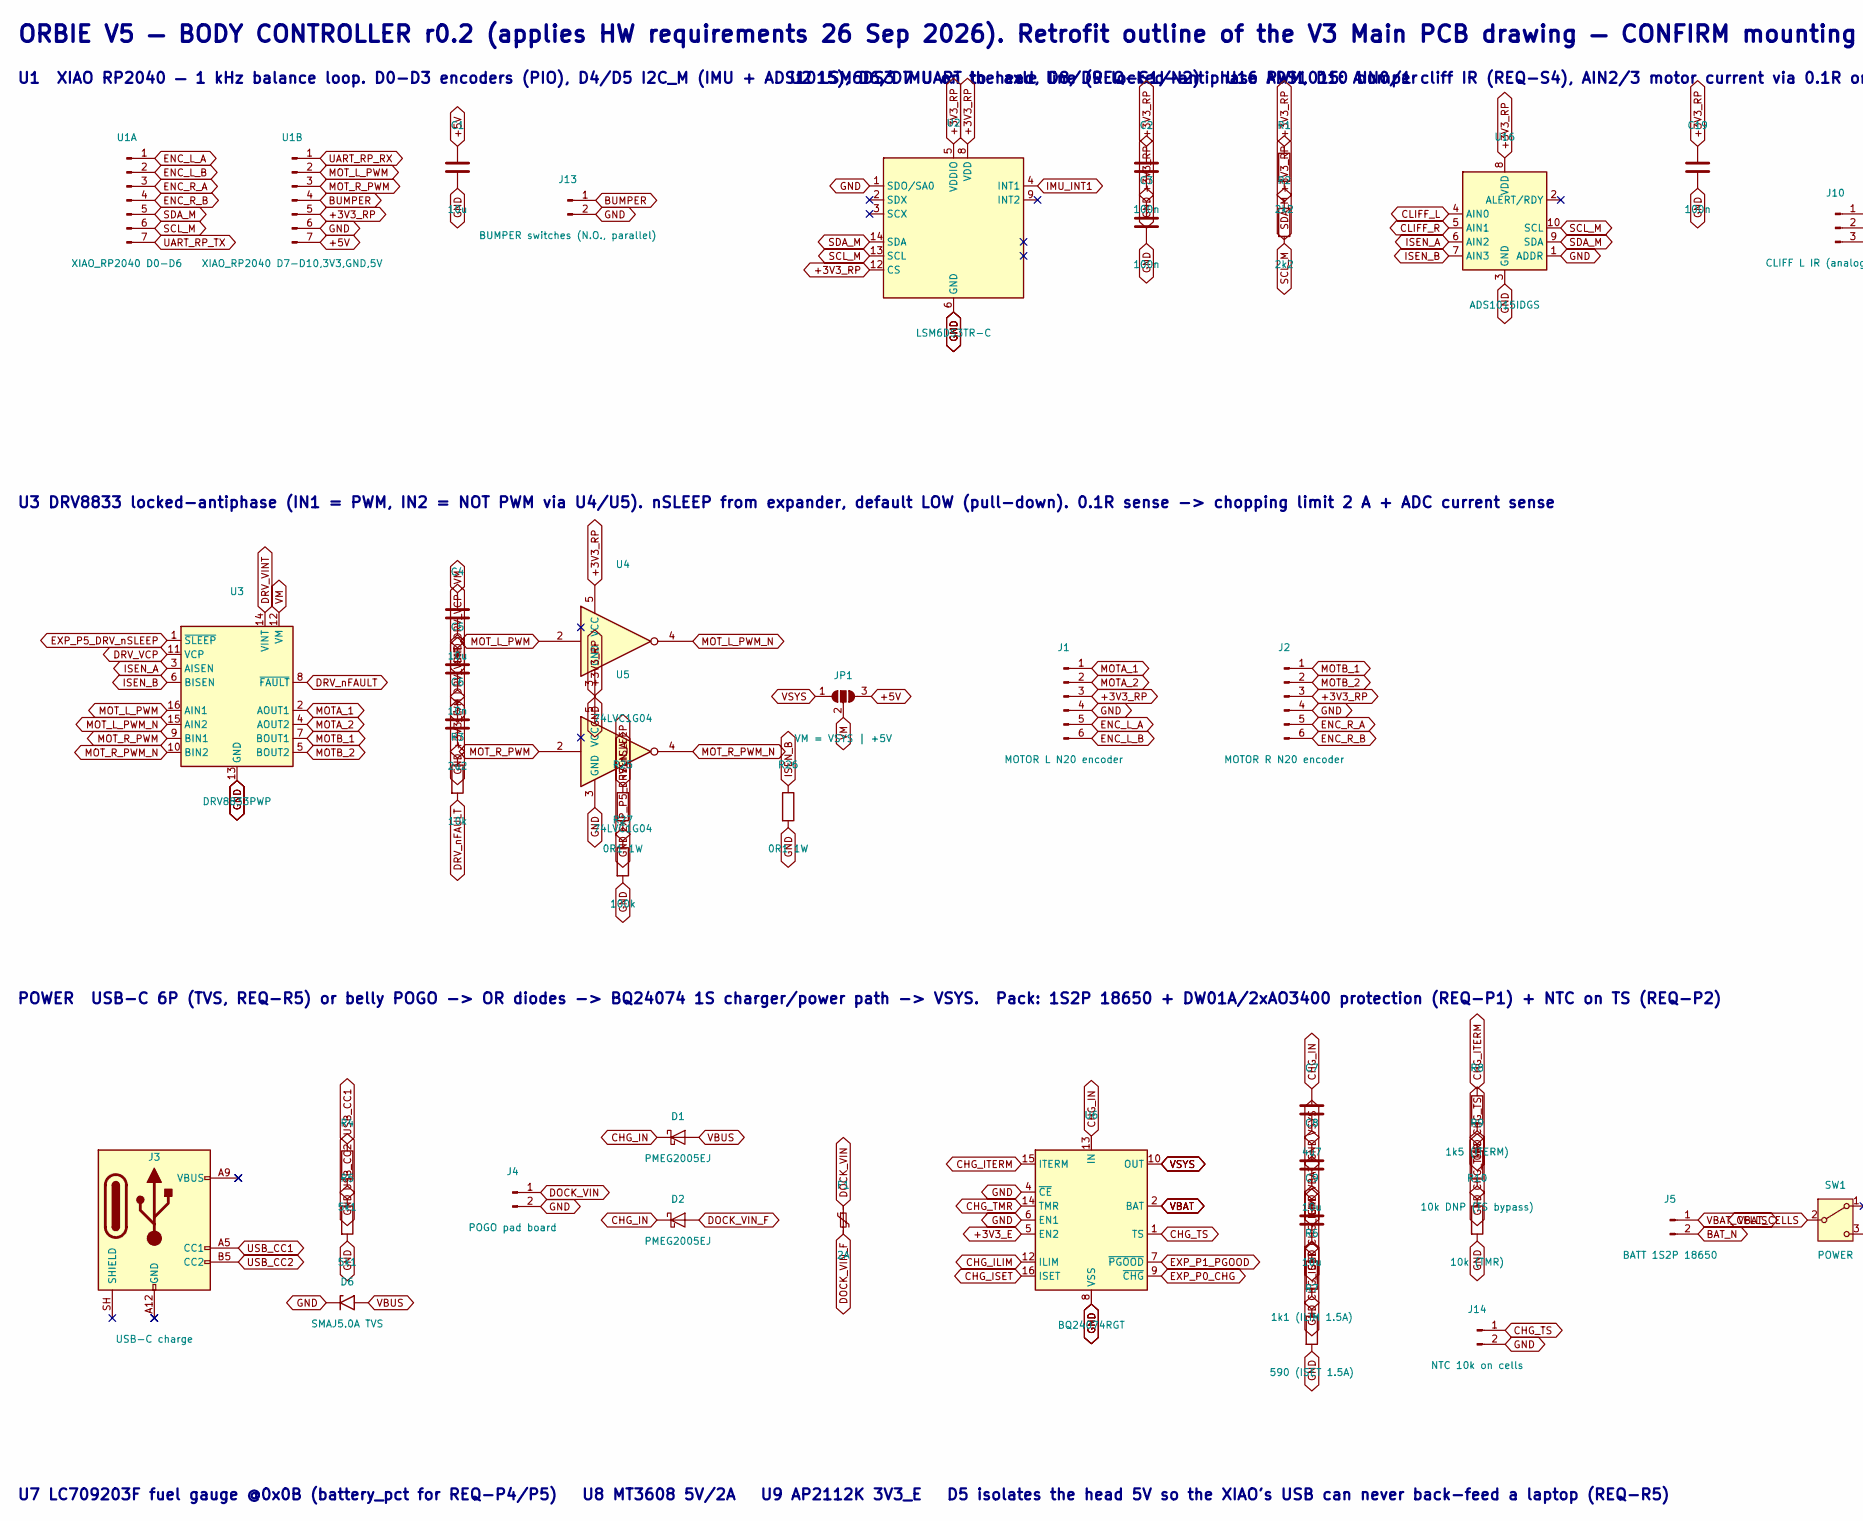
[picture p28: schematic orbie_v5_body.kicad_sch, Orbie V5 Body Controller, part in row 1, column 1]

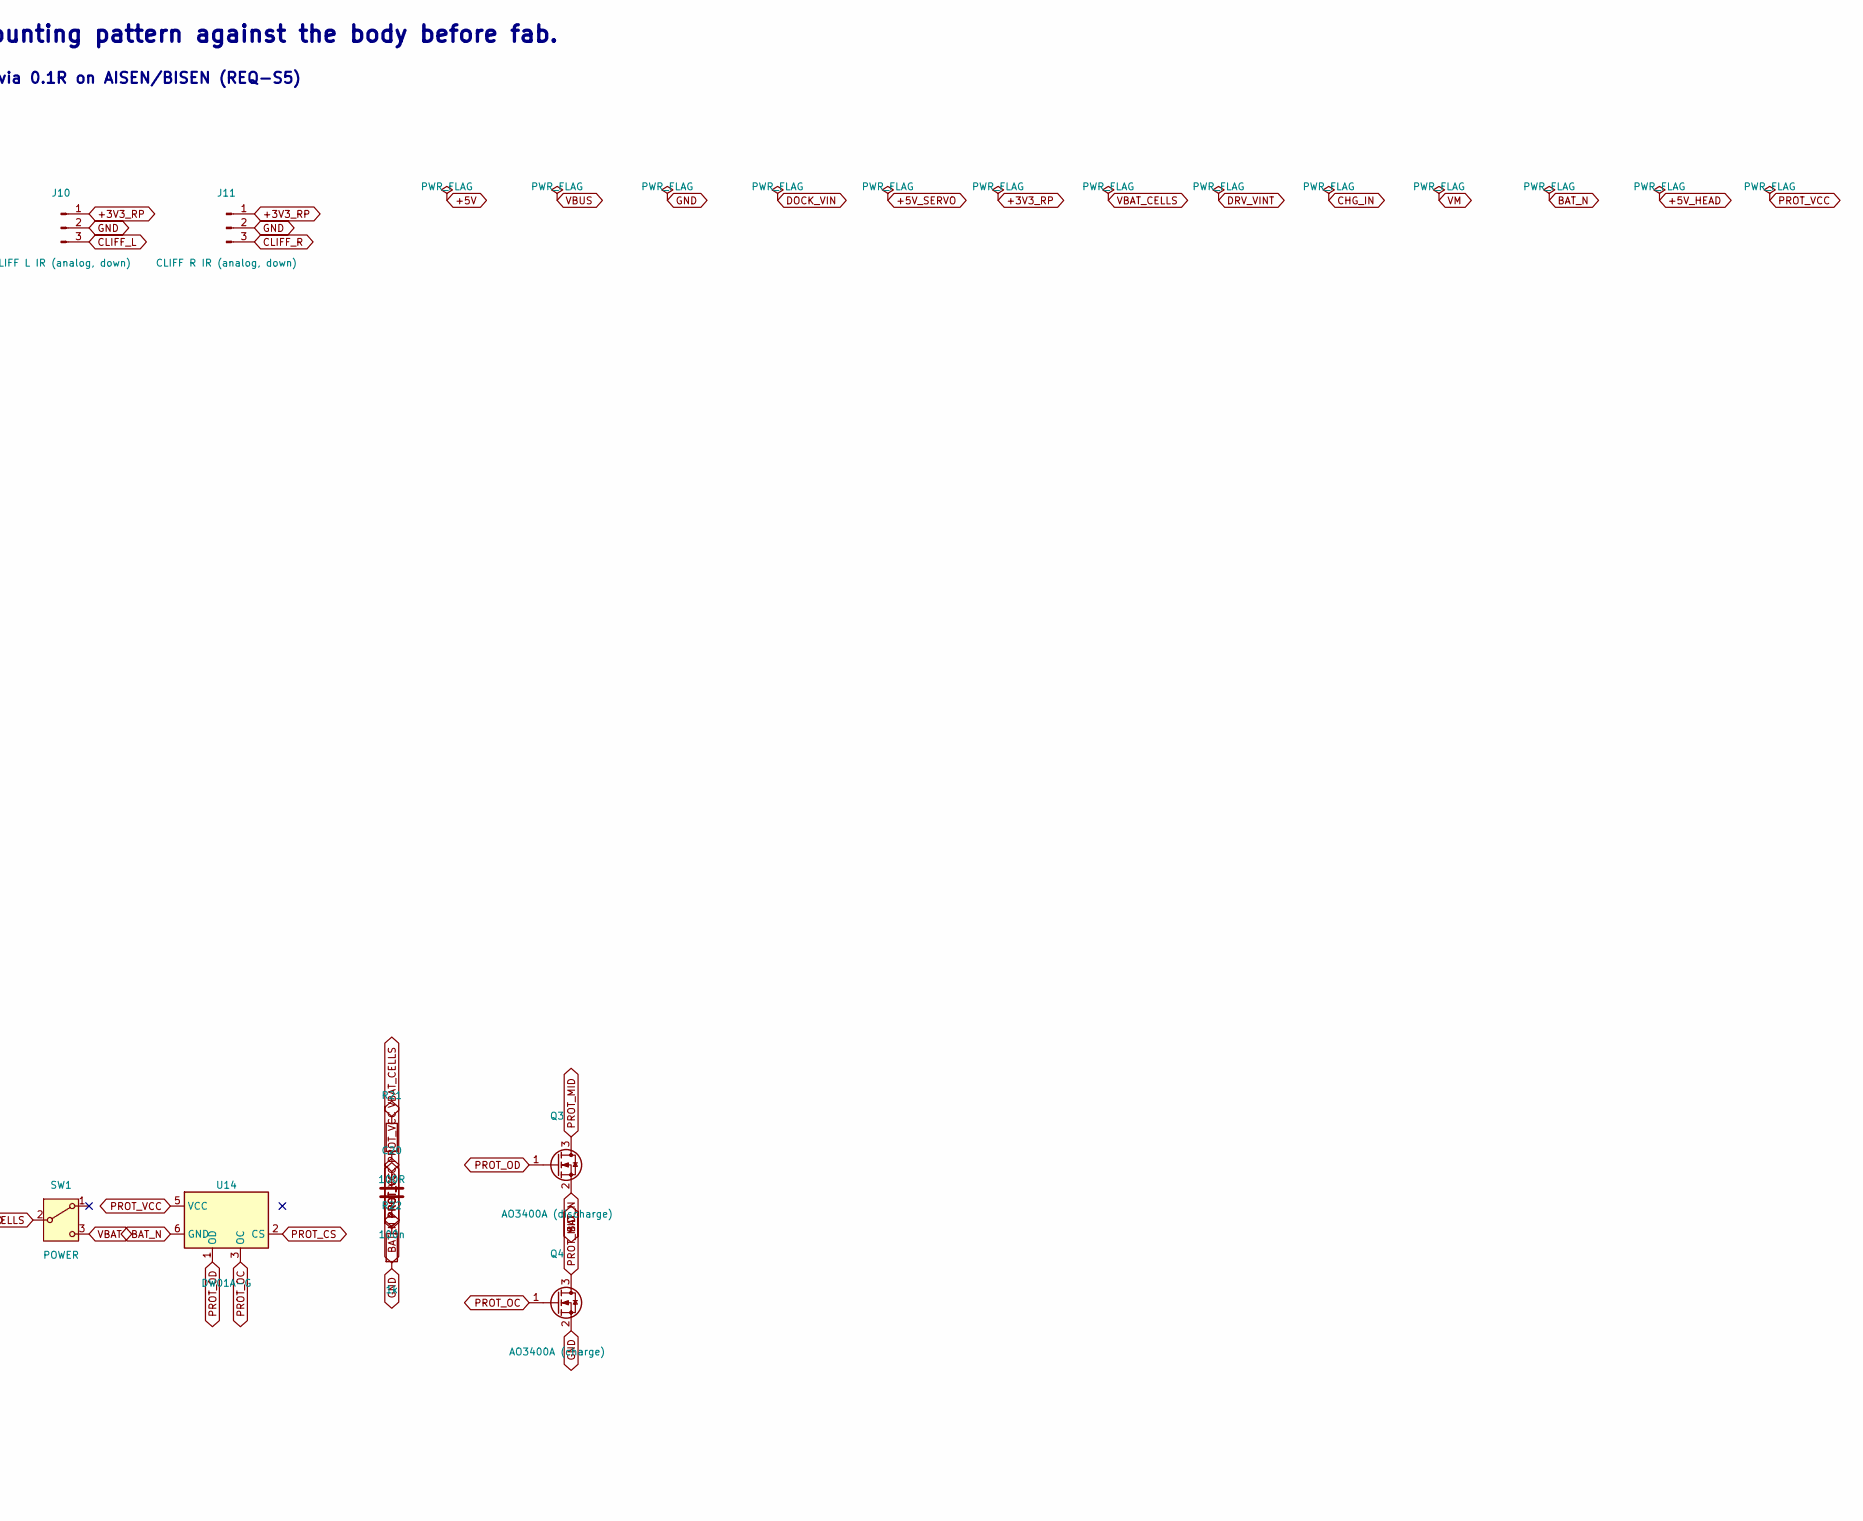
[picture p29: schematic orbie_v5_body.kicad_sch, Orbie V5 Body Controller, part in row 1, column 2]

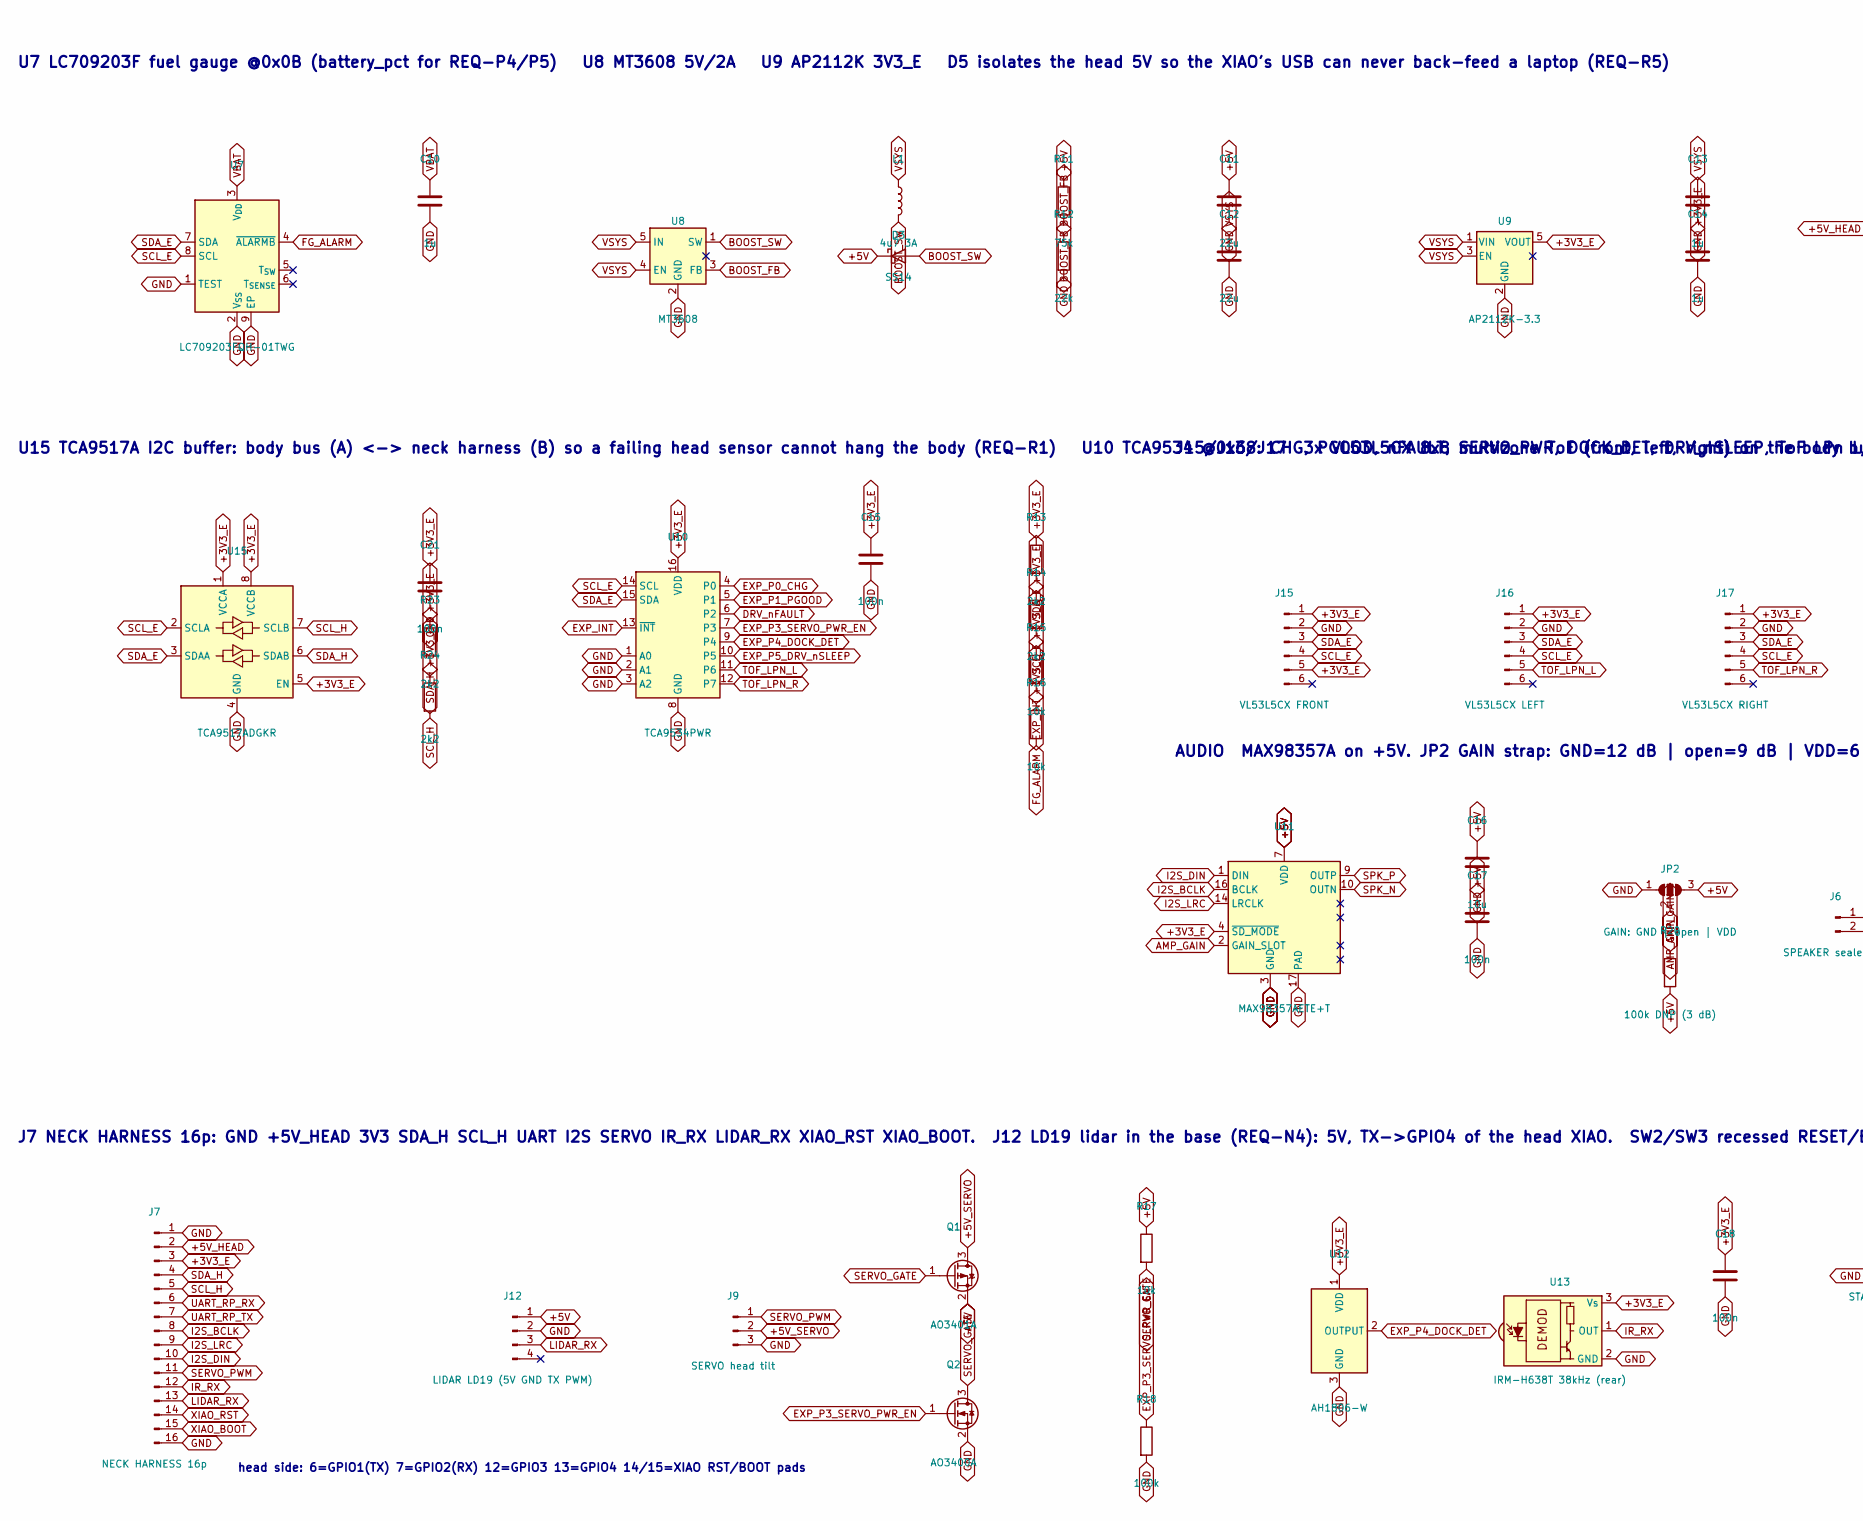
[picture p30: schematic orbie_v5_body.kicad_sch, Orbie V5 Body Controller, part in row 2, column 1]

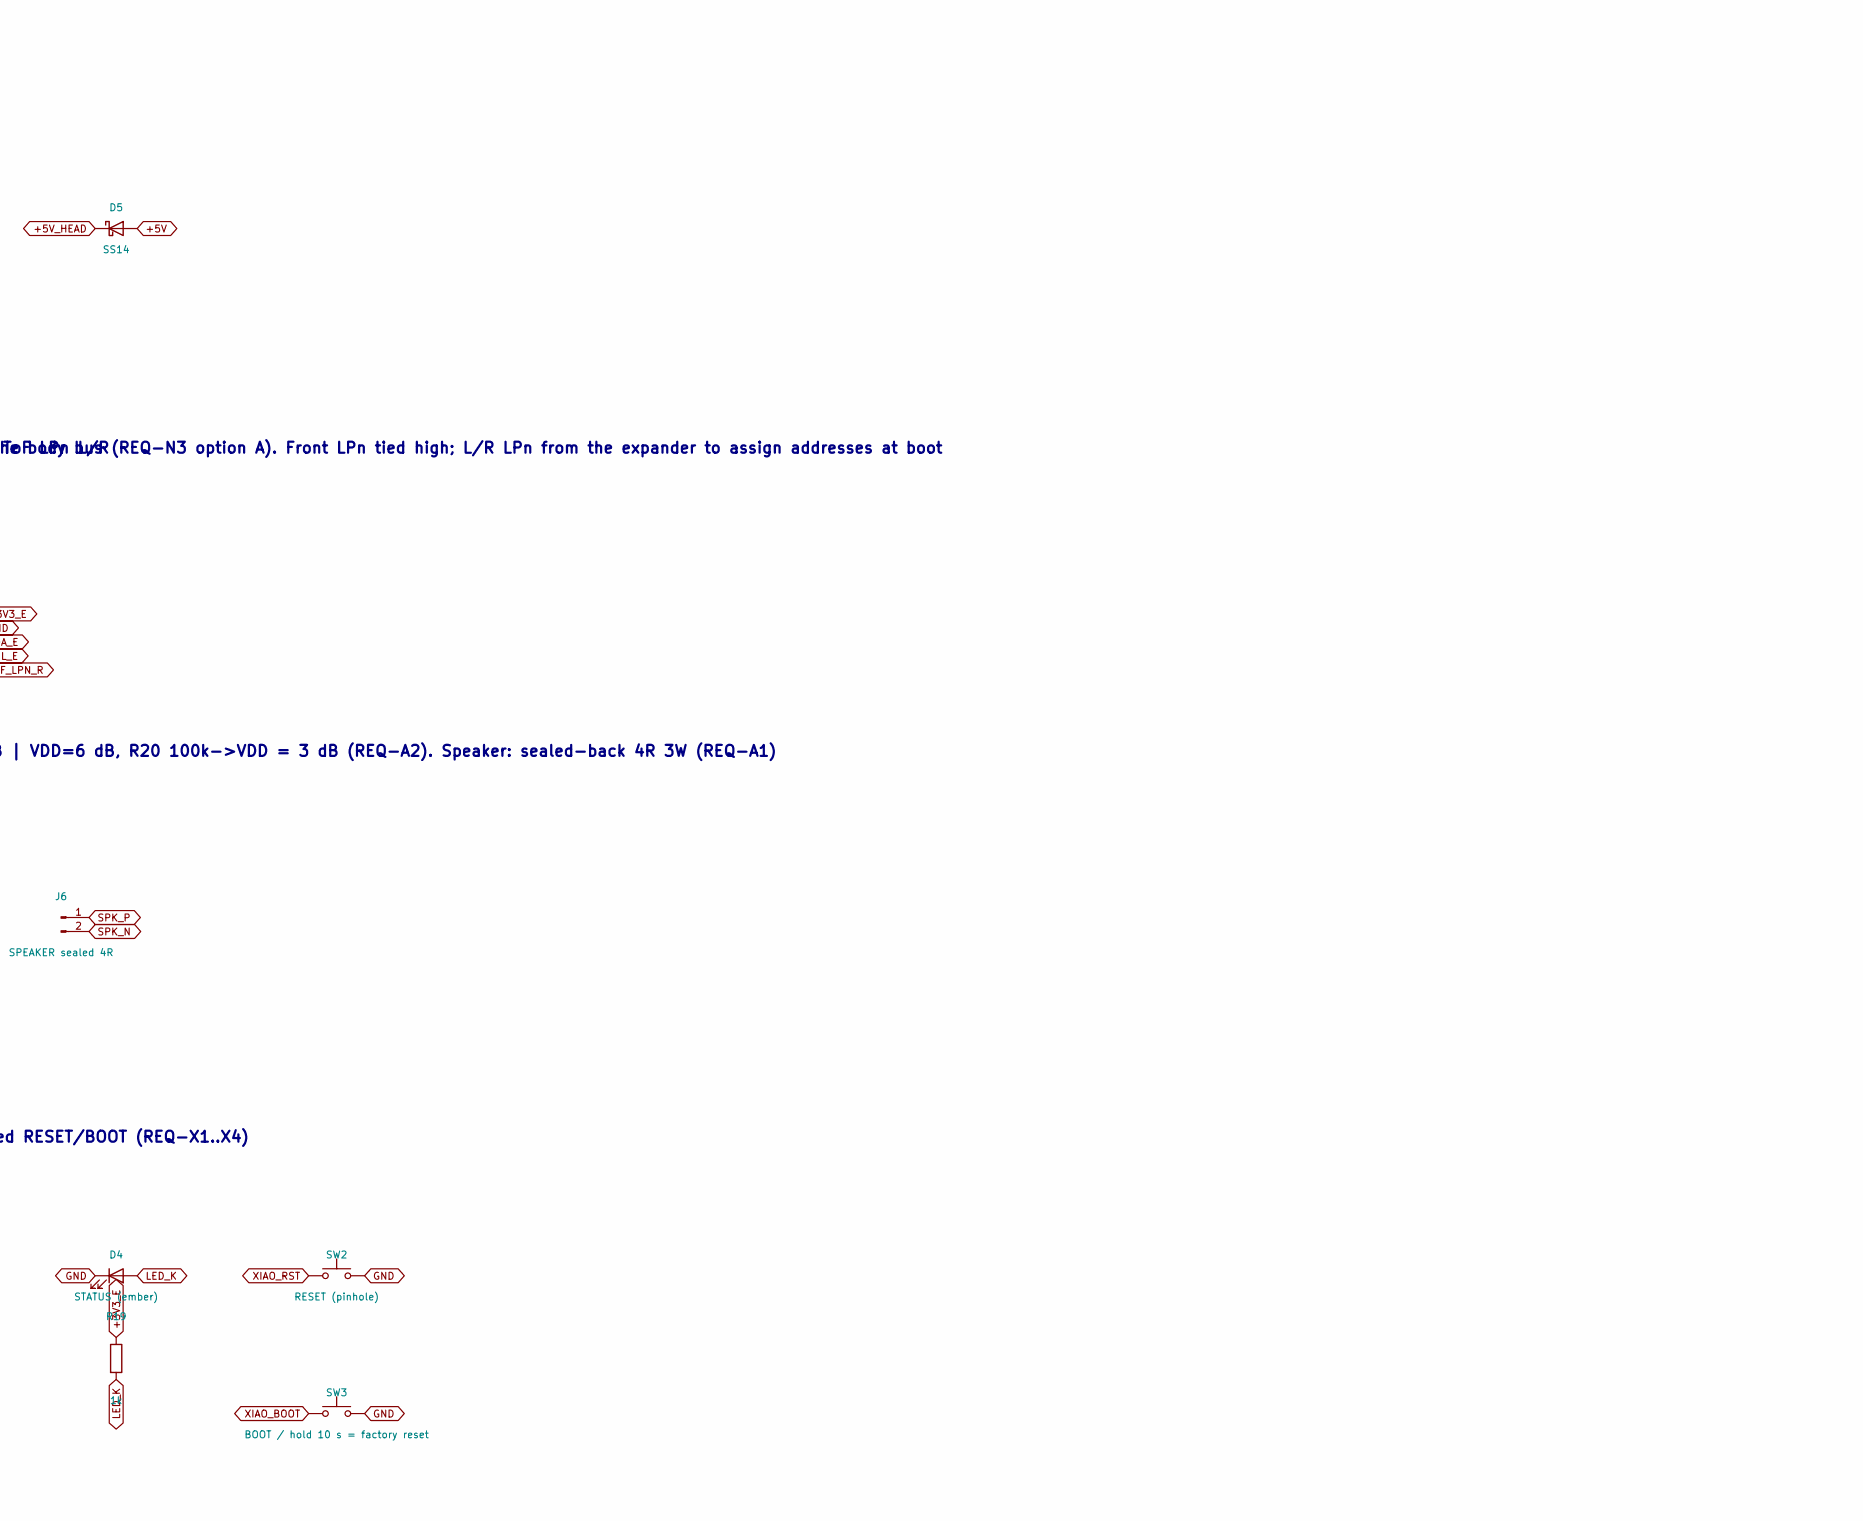
[picture p31: schematic orbie_v5_body.kicad_sch, Orbie V5 Body Controller, part in row 2, column 2]

Parts:
C1, C4, C8, C9, C16: 10u; C_0805_2012Metric_Pad1.18x1.45mm_HandSolder
C2, C3, C15, C17, C18, C19, C20, C21: 100n; C_0603_1608Metric_Pad1.08x0.95mm_HandSolder
C5: 10n; C_0603_1608Metric_Pad1.08x0.95mm_HandSolder
C6: 2u2; C_0603_1608Metric_Pad1.08x0.95mm_HandSolder
C7: 4u7; C_0603_1608Metric_Pad1.08x0.95mm_HandSolder
C10, C13, C14: 1u; C_0603_1608Metric_Pad1.08x0.95mm_HandSolder
C11, C12: 22u; C_1210_3225Metric_Pad1.33x2.70mm_HandSolder
D1, D2: PMEG2005EJ; D_SOD-323F
D3, D5: SS14; D_SMA
D4: STATUS (ember); LED_0603_1608Metric
D6: SMAJ5.0A TVS; D_SMA
F1: 2A; Fuse_1206_3216Metric
J1: MOTOR L N20 encoder; JST_PH_B6B-PH-K_1x06_P2.00mm_Vertical
J2: MOTOR R N20 encoder; JST_PH_B6B-PH-K_1x06_P2.00mm_Vertical
J3: USB-C charge; USB_C_Receptacle_GCT_USB4125-xx-x_6P_TopMnt_Horizontal
J4: POGO pad board; JST_PH_B2B-PH-K_1x02_P2.00mm_Vertical
J5: BATT 1S2P 18650; JST_XH_B2B-XH-A_1x02_P2.50mm_Vertical
J6: SPEAKER sealed 4R; JST_PH_B2B-PH-K_1x02_P2.00mm_Vertical
J7: NECK HARNESS 16p; JST_PH_B16B-PH-K_1x16_P2.00mm_Vertical
J9: SERVO head tilt; JST_PH_B3B-PH-K_1x03_P2.00mm_Vertical
J10: CLIFF L IR (analog, down); JST_PH_B3B-PH-K_1x03_P2.00mm_Vertical
J11: CLIFF R IR (analog, down); JST_PH_B3B-PH-K_1x03_P2.00mm_Vertical
J12: LIDAR LD19 (5V GND TX PWM); JST_ZH_B4B-ZR_1x04_P1.50mm_Vertical
J13: BUMPER switches (N.O., parallel); JST_PH_B2B-PH-K_1x02_P2.00mm_Vertical
J14: NTC 10k on cells; JST_PH_B2B-PH-K_1x02_P2.00mm_Vertical
J15: VL53L5CX FRONT; JST_PH_B6B-PH-K_1x06_P2.00mm_Vertical
J16: VL53L5CX LEFT; JST_PH_B6B-PH-K_1x06_P2.00mm_Vertical
J17: VL53L5CX RIGHT; JST_PH_B6B-PH-K_1x06_P2.00mm_Vertical
JP1: VM = VSYS | +5V; SolderJumper-3_P1.3mm_Open_RoundedPad1.0x1.5mm
JP2: GAIN: GND | open | VDD; SolderJumper-3_P1.3mm_Open_RoundedPad1.0x1.5mm
L1: 4u7 3A; L_Taiyo-Yuden_NR-40xx
Q1: AO3401A; SOT-23_Handsoldering
Q2: AO3400A; SOT-23_Handsoldering
Q3: AO3400A (discharge); SOT-23_Handsoldering
Q4: AO3400A (charge); SOT-23_Handsoldering
R1, R2, R13, R14, R23, R24: 2k2; R_0603_1608Metric_Pad0.98x0.95mm_HandSolder
R3, R15, R16, R17: 10k; R_0603_1608Metric_Pad0.98x0.95mm_HandSolder
R4, R5: 5k1; R_0603_1608Metric_Pad0.98x0.95mm_HandSolder
R6: 1k1 (ILIM 1.5A); R_0603_1608Metric_Pad0.98x0.95mm_HandSolder
R7: 590 (ISET 1.5A); R_0603_1608Metric_Pad0.98x0.95mm_HandSolder
R8: 1k5 (ITERM); R_0603_1608Metric_Pad0.98x0.95mm_HandSolder
R9: 10k DNP (TS bypass); R_0603_1608Metric_Pad0.98x0.95mm_HandSolder
R10: 10k (TMR); R_0603_1608Metric_Pad0.98x0.95mm_HandSolder
R11: 75k; R_0603_1608Metric_Pad0.98x0.95mm_HandSolder
R12: 22k; R_0603_1608Metric_Pad0.98x0.95mm_HandSolder
R18, R27: 100k; R_0603_1608Metric_Pad0.98x0.95mm_HandSolder
R19, R22: 1k; R_0603_1608Metric_Pad0.98x0.95mm_HandSolder
R20: 100k DNP (3 dB); R_0603_1608Metric_Pad0.98x0.95mm_HandSolder
R21: 100R; R_0603_1608Metric_Pad0.98x0.95mm_HandSolder
R25, R26: 0R1 1W; R_1206_3216Metric
SW1: POWER; SW_SPDT_PCM12
SW2: RESET (pinhole); SW_Push_SPST_NO_Alps_SKRK
SW3: BOOT / hold 10 s = factory reset; SW_Push_SPST_NO_Alps_SKRK
U1A: XIAO_RP2040 D0-D6; XIAO_Castellated
U1B: XIAO_RP2040 D7-D10,3V3,GND,5V; XIAO_Castellated
U2: LSM6DS3TR-C; LGA-14_3x2.5mm_P0.5mm_LayoutBorder3x4y
U3: DRV8833PWP; HTSSOP-16-1EP_4.4x5mm_P0.65mm_EP3.4x5mm
U4, U5: 74LVC1G04; SOT-23-5_HandSoldering
U6: BQ24074RGT; VQFN-16-1EP_3x3mm_P0.5mm_EP1.68x1.68mm
U7: LC709203FQH-01TWG; WDFN-8-1EP_3x2mm_P0.5mm_EP1.3x1.4mm
U8: MT3608; SOT-23-6
U9: AP2112K-3.3; SOT-23-5_HandSoldering
U10: TCA9534PWR; TSSOP-16_4.4x5mm_P0.65mm
U11: MAX98357AETE+T; QFN-16-1EP_3x3mm_P0.5mm_EP1.75x1.75mm
U12: AH1806-W; SOT-23_Handsoldering
U13: IRM-H638T 38kHz (rear); Everlight_IRM-H6xxT
U14: DW01A-G; SOT-23-6_Handsoldering
U15: TCA9517ADGKR; MSOP-8_3x3mm_P0.65mm
U16: ADS1015IDGS; TSSOP-10_3x3mm_P0.5mm

Connections:
+3V3_E: C14.1, C15.1, C18.1, C21.1, J7.3, J15.1, J15.5, J16.1, J17.1, R3.1, R13.1, R14.1, R15.1, R16.1, R19.1, R23.1, R24.1, U6.5 (EN2), U9.5 (VOUT), U10.16 (VDD), U11.4 (~SD_MODE), U12.1 (VDD), U13.3 (Vs), U15.1 (VCCA), U15.5 (EN), U15.8 (VCCB)
+3V3_RP: C2.1, C3.1, C19.1, J1.3, J2.3, J10.1, J11.1, R1.1, R2.1, U1A.12, U1B.5, U2.5 (VDDIO), U2.8 (VDD), U2.12 (CS), U4.5 (VCC), U5.5 (VCC), U16.8 (VDD)
+5V: C1.1, C11.1, C16.1, C17.1, D3.1 (K), D5.2 (A), J12.1, JP1.3 (B), JP2.3 (B), Q1.2 (S), R11.1, R17.1, R20.2, U1A.14, U1B.7, U11.7 (VDD), U11.8 (VDD)
+5V_HEAD: D5.1 (K), J7.2
+5V_SERVO: J9.2, Q1.3 (D)
AMP_GAIN: JP2.2 (C), R20.1, U11.2 (GAIN_SLOT)
BAT_N: C20.2, J5.2, Q3.2 (S), U14.6 (GND)
BOOST_FB: R11.2, R12.1, U8.3 (FB)
BOOST_SW: D3.2 (A), L1.2, U8.1 (SW)
BUMPER: J13.1, U1A.11, U1B.4
CHG_ILIM: R6.1, U6.12 (ILIM)
CHG_IN: C7.1, D1.1 (K), D2.1 (K), U6.13 (IN)
CHG_ISET: R7.1, U6.16 (ISET)
CHG_ITERM: R8.1, U6.15 (ITERM)
CHG_TMR: R10.1, U6.14 (TMR)
CHG_TS: J14.1, R9.1, U6.1 (TS)
CLIFF_L: J10.3, U16.4 (AIN0)
CLIFF_R: J11.3, U16.5 (AIN1)
DOCK_VIN: F1.1, J4.1
DOCK_VIN_F: D2.2 (A), F1.2
DRV_VCP: C5.1, U3.11 (VCP)
DRV_VINT: C6.1, U3.14 (VINT)
DRV_nFAULT: R3.2, U3.8 (~FAULT), U10.6 (P2)
ENC_L_A: J1.5, U1A.1
ENC_L_B: J1.6, U1A.2
ENC_R_A: J2.5, U1A.3
ENC_R_B: J2.6, U1A.4
EXP_INT: R15.2, U10.13 (~INT)
EXP_P0_CHG: U6.9 (~CHG), U10.4 (P0)
EXP_P1_PGOOD: U6.7 (~PGOOD), U10.5 (P1)
EXP_P3_SERVO_PWR_EN: Q2.1 (G), R18.1, U10.7 (P3)
EXP_P4_DOCK_DET: U10.9 (P4), U12.2 (OUTPUT)
EXP_P5_DRV_nSLEEP: R27.1, U3.1 (~SLEEP), U10.10 (P5)
FG_ALARM: R16.2, U7.4 (~ALARMB)
GND: C1.2, C2.2, C3.2, C4.2, C6.2, C7.2, C8.2, C9.2, C10.2, C11.2, C12.2, C13.2, C14.2, C15.2, C16.2, C17.2, C18.2, C19.2, C21.2, D4.1 (K), D6.1 (A1), J1.4, J2.4, J4.2, J7.1, J7.16, J9.3, J10.2, J11.2, J12.2, J13.2, J14.2, J15.2, J16.2, J17.2, JP2.1 (A), Q2.2 (S), Q4.2 (S), R4.2, R5.2, R6.2, R7.2, R8.2, R9.2, R10.2, R12.2, R18.2, R22.2, R25.2, R26.2, R27.2, SW2.2, SW3.2, U1A.13, U1B.6, U2.1 (SDO/SA0), U2.6 (GND), U2.7 (GND), U3.13 (GND), U3.17 (GND), U4.3 (GND), U5.3 (GND), U6.4 (~CE), U6.6 (EN1), U6.8 (VSS), U6.17 (VSS), U7.1 (TEST), U7.2 (V_{SS}), U7.9 (EP), U8.2 (GND), U9.2 (GND), U10.1 (A0), U10.2 (A1), U10.3 (A2), U10.8 (GND), U11.3 (GND), U11.11 (GND), U11.15 (GND), U11.17 (PAD), U12.3 (GND), U13.2 (GND), U15.4 (GND), U16.1 (ADDR), U16.3 (GND)
I2S_BCLK: J7.8, U11.16 (BCLK)
I2S_DIN: J7.10, U11.1 (DIN)
I2S_LRC: J7.9, U11.14 (LRCLK)
IMU_INT1: U2.4 (INT1)
IR_RX: J7.12, U13.1 (OUT)
ISEN_A: R25.1, U3.3 (AISEN), U16.6 (AIN2)
ISEN_B: R26.1, U3.6 (BISEN), U16.7 (AIN3)
LED_K: D4.2 (A), R19.2
LIDAR_RX: J7.13, J12.3
MOTA_1: J1.1, U3.2 (AOUT1)
MOTA_2: J1.2, U3.4 (AOUT2)
MOTB_1: J2.1, U3.7 (BOUT1)
MOTB_2: J2.2, U3.5 (BOUT2)
MOT_L_PWM: U1A.9, U1B.2, U3.16 (AIN1), U4.2
MOT_L_PWM_N: U3.15 (AIN2), U4.4
MOT_R_PWM: U1A.10, U1B.3, U3.9 (BIN1), U5.2
MOT_R_PWM_N: U3.10 (BIN2), U5.4
PROT_CS: R22.1, U14.2 (CS)
PROT_MID: Q3.3 (D), Q4.3 (D)
PROT_OC: Q4.1 (G), U14.3 (OC)
PROT_OD: Q3.1 (G), U14.1 (OD)
PROT_VCC: C20.1, R21.2, U14.5 (VCC)
SCL_E: J15.4, J16.4, J17.4, R14.2, U7.8 (SCL), U10.14 (SCL), U15.2 (SCLA)
SCL_H: J7.5, R24.2, U15.7 (SCLB)
SCL_M: R2.2, U1A.6, U2.13 (SCL), U16.10 (SCL)
SDA_E: J15.3, J16.3, J17.3, R13.2, U7.7 (SDA), U10.15 (SDA), U15.3 (SDAA)
SDA_H: J7.4, R23.2, U15.6 (SDAB)
SDA_M: R1.2, U1A.5, U2.14 (SDA), U16.9 (SDA)
SERVO_GATE: Q1.1 (G), Q2.3 (D), R17.2
SERVO_PWM: J7.11, J9.1
SPK_N: J6.2, U11.10 (OUTN)
SPK_P: J6.1, U11.9 (OUTP)
TOF_LPN_L: J16.5, U10.11 (P6)
TOF_LPN_R: J17.5, U10.12 (P7)
UART_RP_RX: J7.6, U1A.8, U1B.1
UART_RP_TX: J7.7, U1A.7
USB_CC1: J3.A5 (CC1), R4.1
USB_CC2: J3.B5 (CC2), R5.1
VBAT: C9.1, C10.1, SW1.3 (C), U6.2 (BAT), U6.3 (BAT), U7.3 (V_{DD})
VBAT_CELLS: J5.1, R21.1, SW1.2 (B)
VBUS: D1.2 (A), D6.2 (A2)
VM: C4.1, C5.2, JP1.2 (C), U3.12 (VM)
VSYS: C8.1, C12.1, C13.1, JP1.1 (A), L1.1, U6.10 (OUT), U6.11 (OUT), U8.4 (EN), U8.5 (IN), U9.1 (VIN), U9.3 (EN)
XIAO_BOOT: J7.15, SW3.1
XIAO_RST: J7.14, SW2.1

Notes on the sheet:
ORBIE V5 — BODY CONTROLLER r0.2 (applies HW requirements 26 Sep 2026). Retrofit outline of the V3 Main PCB drawing — CONFIRM mounting pattern against the body before fab.
U1 XIAO RP2040 — 1 kHz balance loop. D0-D3 encoders (PIO), D4/D5 I2C_M (IMU + ADS1015), D6/D7 UART to head, D8/D9 locked-antiphase PWM, D10 bumper
U2 LSM6DS3 IMU on the axle line (REQ-S1/N2) U16 ADS1015: AIN0/1 cliff IR (REQ-S4), AIN2/3 motor current via 0.1R on AISEN/BISEN (REQ-S5)
U3 DRV8833 locked-antiphase (IN1 = PWM, IN2 = NOT PWM via U4/U5). nSLEEP from expander, default LOW (pull-down). 0.1R sense -> chopping limit 2 A + ADC current sense
POWER USB-C 6P (TVS, REQ-R5) or belly POGO -> OR diodes -> BQ24074 1S charger/power path -> VSYS. Pack: 1S2P 18650 + DW01A/2xAO3400 protection (REQ-P1) + NTC on TS (REQ-P2)
U7 LC709203F fuel gauge @0x0B (battery_pct for REQ-P4/P5) U8 MT3608 5V/2A U9 AP2112K 3V3_E D5 isolates the head 5V so the XIAO's USB can never back-feed a laptop (REQ-R5)
U15 TCA9517A I2C buffer: body bus (A) <-> neck harness (B) so a failing head sensor cannot hang the body (REQ-R1) U10 TCA9534 @0x38: CHG, PGOOD, nFAULT, SERVO_PWR, DOCK_DET, DRV_nSLEEP, ToF LPn L/R
J15/J16/J17 3x VL53L5CX 8x8 multizone ToF (front, left, right) on the body bus (REQ-N3 option A). Front LPn tied high; L/R LPn from the expander to assign addresses at boot
AUDIO MAX98357A on +5V. JP2 GAIN strap: GND=12 dB | open=9 dB | VDD=6 dB, R20 100k->VDD = 3 dB (REQ-A2). Speaker: sealed-back 4R 3W (REQ-A1)
J7 NECK HARNESS 16p: GND +5V_HEAD 3V3 SDA_H SCL_H UART I2S SERVO IR_RX LIDAR_RX XIAO_RST XIAO_BOOT. J12 LD19 lidar in the base (REQ-N4): 5V, TX->GPIO4 of the head XIAO. SW2/SW3 recessed RESET/BOOT (REQ-X1..X4)
head side: 6=GPIO1(TX) 7=GPIO2(RX) 12=GPIO3 13=GPIO4 14/15=XIAO RST/BOOT pads

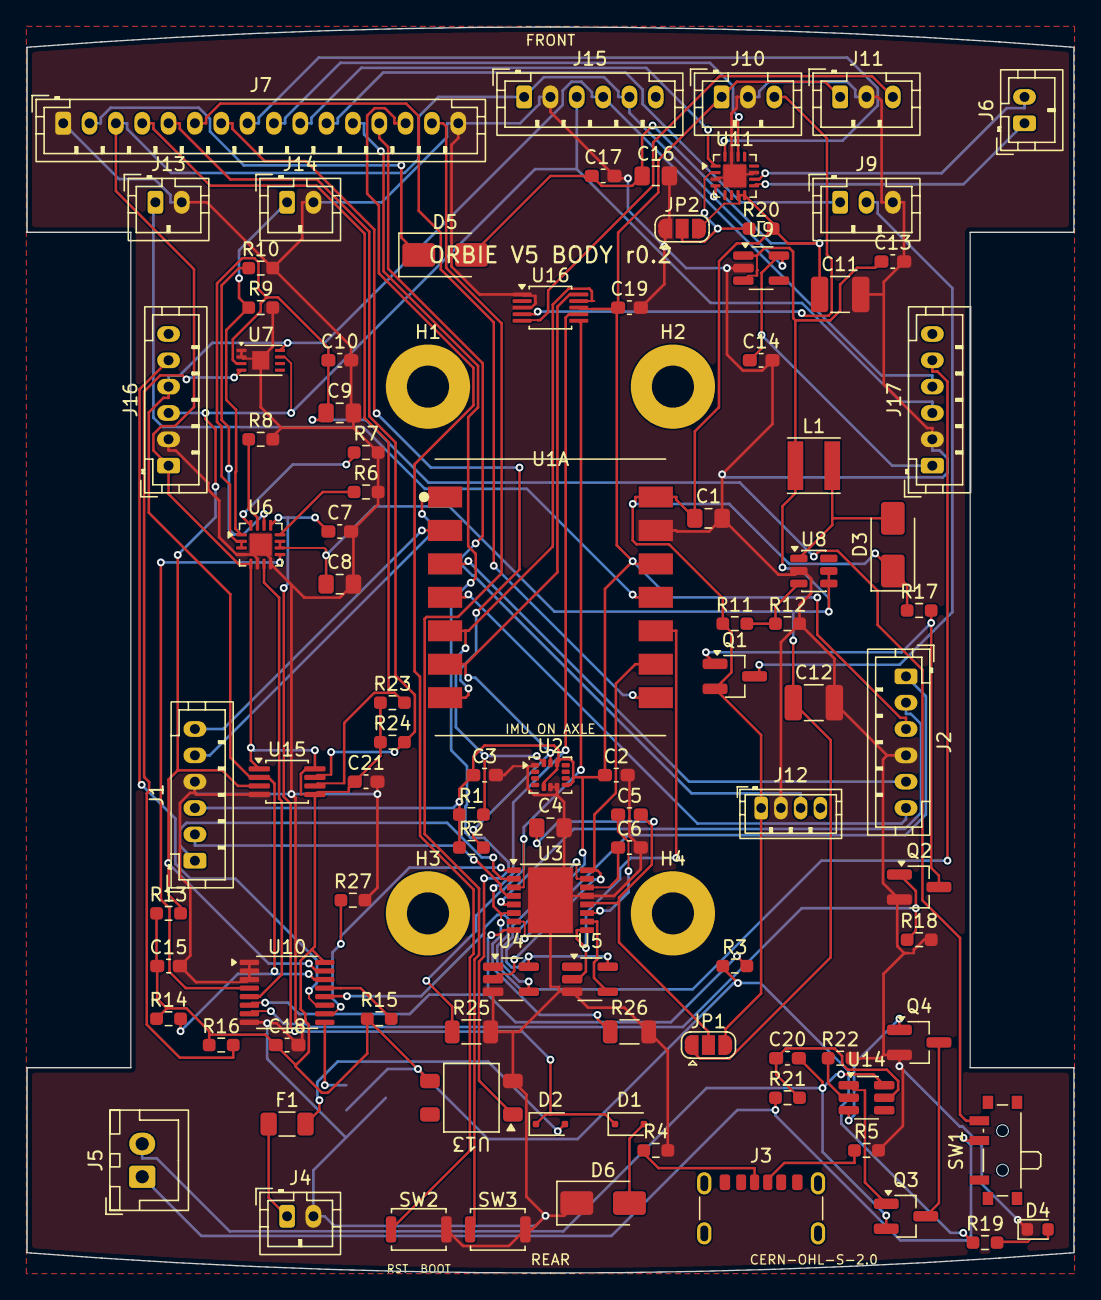
[picture p32: board orbie_v5_body.kicad_pcb from above]

Board: 2 copper layers, 79.5 x 94.6 mm, 101 parts (1 on the bottom side), 79 nets.

Other parts of the board:
H1, H2, H3, H4: MountingHole_3.2mm_M3_Pad
