orbierobot/orbierobot-firmware/hardware/v5/orbie_v5_pogo.kicad_pcb

## KiCad design hardware/v5/orbie_v5_pogo.kicad_pcb (2026-10-01)

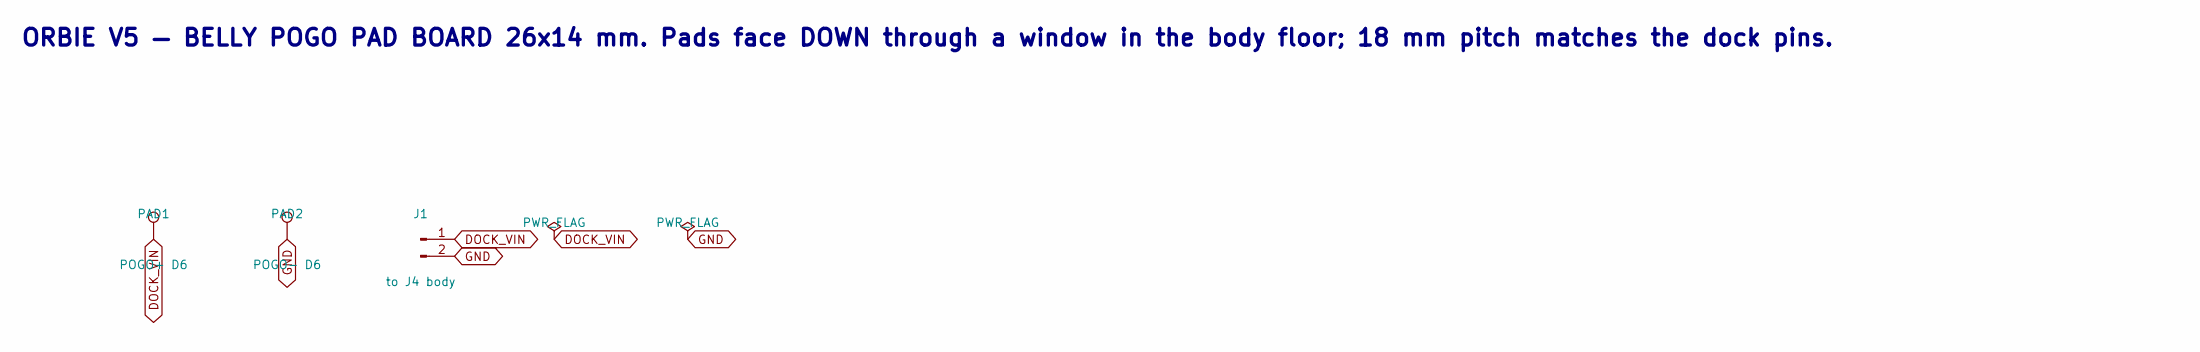
[picture p33: schematic orbie_v5_pogo.kicad_sch, Orbie V5 Pogo Pad Board]

Parts:
J1: to J4 body; JST_PH_B2B-PH-K_1x02_P2.00mm_Vertical
PAD1: POGO+ D6; PogoPad_D6mm
PAD2: POGO- D6; PogoPad_D6mm

Connections:
DOCK_VIN: J1.1, PAD1.1
GND: J1.2, PAD2.1

Notes on the sheet:
ORBIE V5 — BELLY POGO PAD BOARD 26x14 mm. Pads face DOWN through a window in the body floor; 18 mm pitch matches the dock pins.

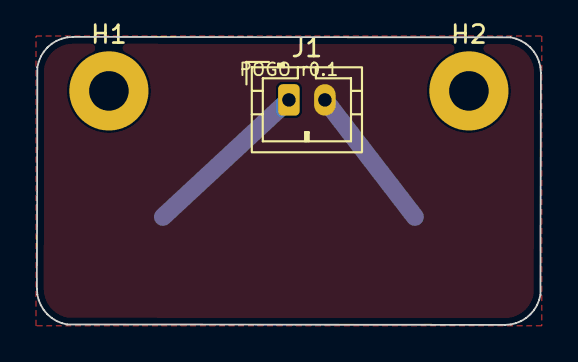
[picture p34: board orbie_v5_pogo.kicad_pcb from above]

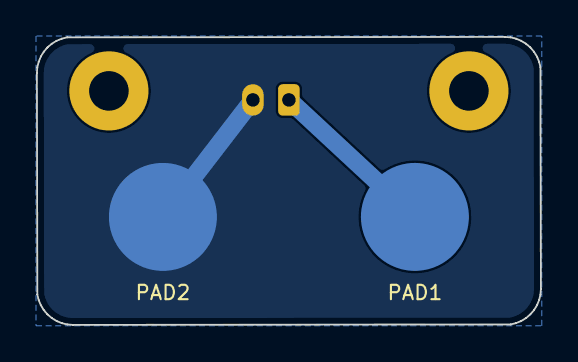
[picture p35: board orbie_v5_pogo.kicad_pcb from below]

Board: 2 copper layers, 28.0 x 16.0 mm, 5 parts (2 on the bottom side), 2 nets.

Other parts of the board:
H1, H2: MountingHole_2.2mm_M2_Pad
