orbierobot/orbierobot-firmware/hardware/v5/orbie_v5_water.kicad_pcb

## KiCad design hardware/v5/orbie_v5_water.kicad_pcb (2026-10-01)

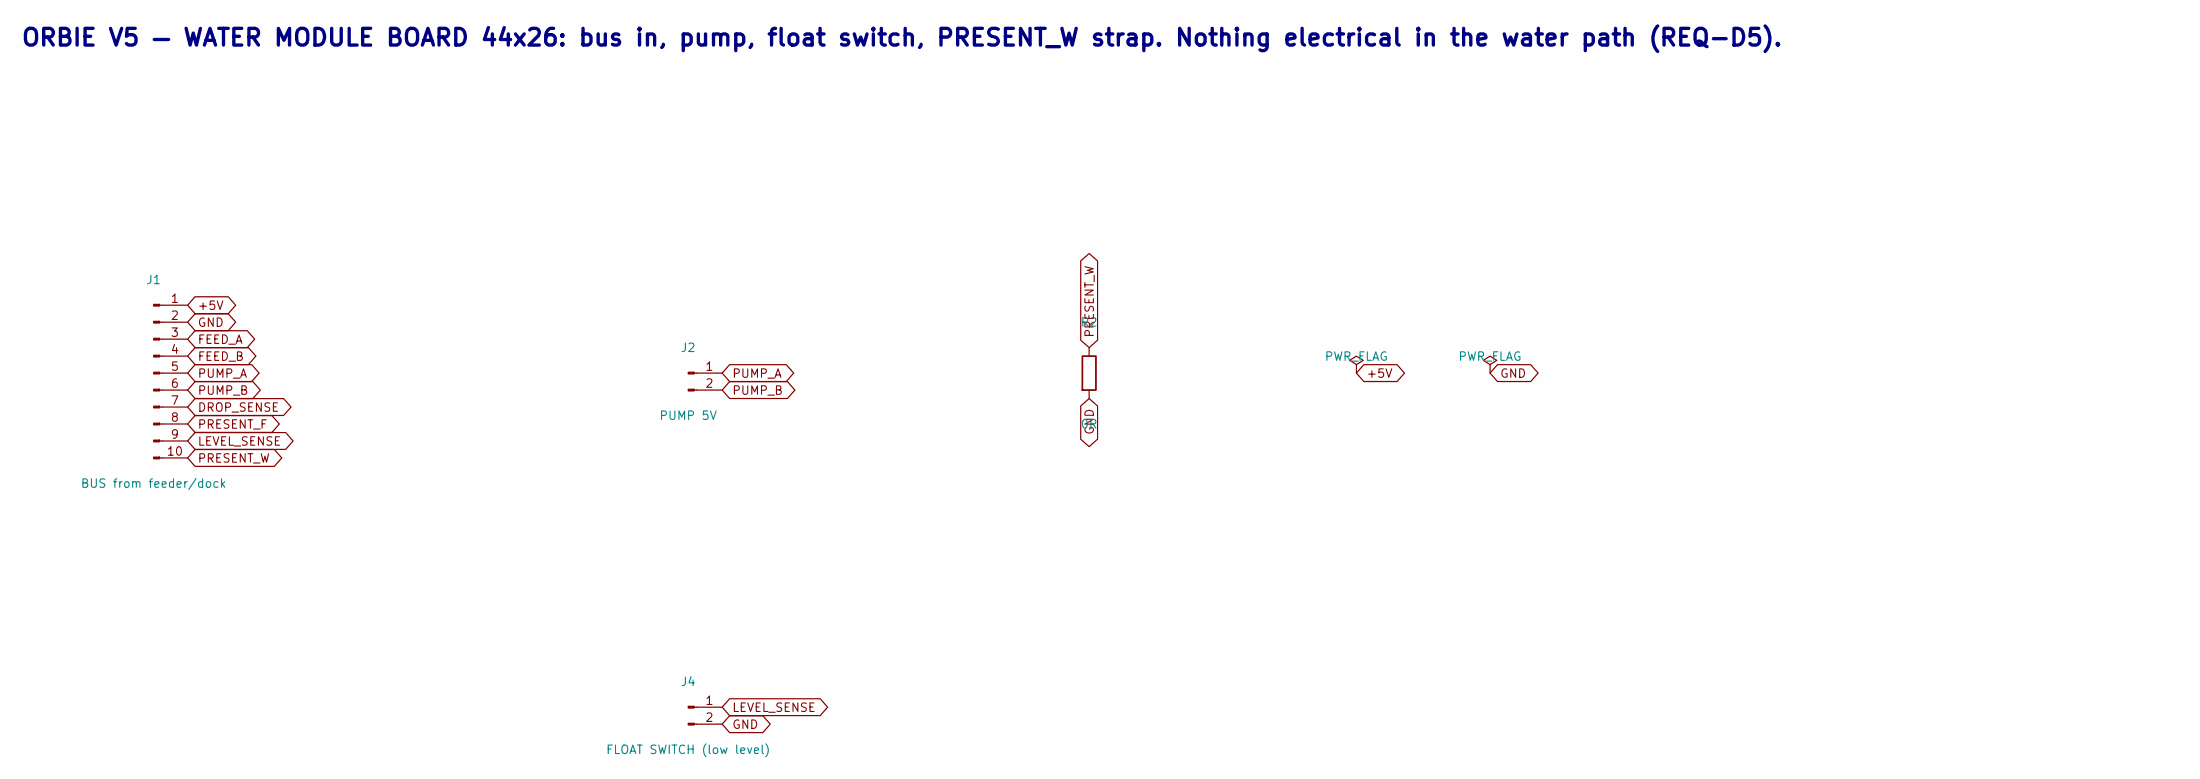
[picture p36: schematic orbie_v5_water.kicad_sch, Orbie V5 Water Module Board]

Parts:
J1: BUS from feeder/dock; JST_PH_B10B-PH-K_1x10_P2.00mm_Vertical
J2: PUMP 5V; JST_PH_B2B-PH-K_1x02_P2.00mm_Vertical
J4: FLOAT SWITCH (low level); JST_PH_B2B-PH-K_1x02_P2.00mm_Vertical
R2: 0R; R_0603_1608Metric_Pad0.98x0.95mm_HandSolder

Connections:
+5V: J1.1
DROP_SENSE: J1.7
FEED_A: J1.3
FEED_B: J1.4
GND: J1.2, J4.2, R2.2
LEVEL_SENSE: J1.9, J4.1
PRESENT_F: J1.8
PRESENT_W: J1.10, R2.1
PUMP_A: J1.5, J2.1
PUMP_B: J1.6, J2.2

Notes on the sheet:
ORBIE V5 — WATER MODULE BOARD 44x26: bus in, pump, float switch, PRESENT_W strap. Nothing electrical in the water path (REQ-D5).

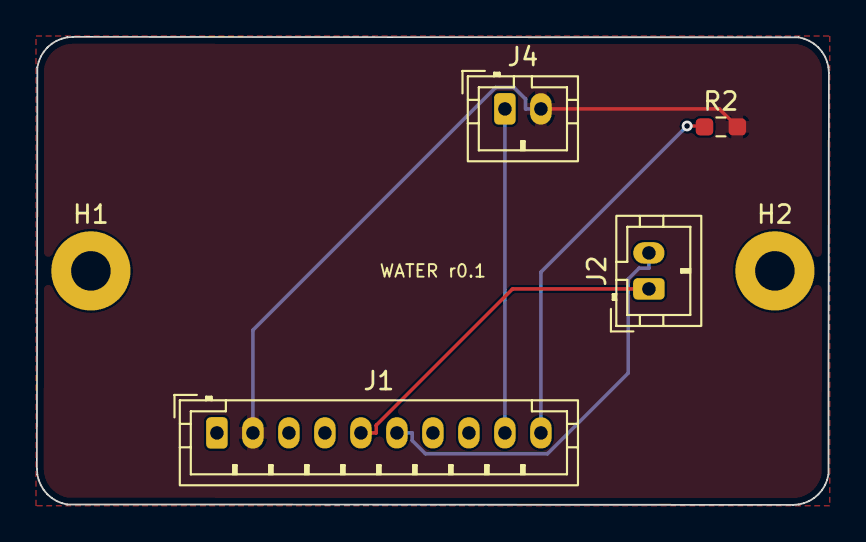
[picture p37: board orbie_v5_water.kicad_pcb from above]

Board: 2 copper layers, 44.0 x 26.0 mm, 6 parts (0 on the bottom side), 5 nets.

Other parts of the board:
H1, H2: MountingHole_2.2mm_M2_Pad
