orbierobot/orbierobot-firmware/main/boot_expressions.h

#pragma once

// Common frame struct for all animations
// ExprFrame typedef is in led_display.h (included first)

// =============================================================
//  EXPRESSION 1: "wakeup"  (4 frames, 2500ms total)
// =============================================================

const uint8_t expr_wakeup_f0[384] = {
  /* y=0 */   0,  0,  0,   0,  0,  0,   0,  0,  0,   0,  0,  0,   0,  0,  0,   0,  0,  0,   0,  0,  0,   0,  0,  0,   0,  0,  0,   0,  0,  0,   0,  0,  0,   0,  0,  0,   0,  0,  0,   0,  0,  0,   0,  0,  0,   0,  0,  0,
  /* y=1 */   0,  0,  0,   0,  0,  0,   0,  0,  0,   0,  0,  0,   0,  0,  0,   0,  0,  0,   0,  0,  0,   0,  0,  0,   0,  0,  0,   0,  0,  0,   0,  0,  0,   0,  0,  0,   0,  0,  0,   0,  0,  0,   0,  0,  0,   0,  0,  0,
  /* y=2 */   0,  0,  0,   0,  0,  0,   0,  0,  0,   0,  0,  0,   0,  0,  0,   0,  0,  0,   0,  0,  0,   0,  0,  0,   0,  0,  0,   0,  0,  0,   0,  0,  0,   0,  0,  0,   0,  0,  0,   0,  0,  0,   0,  0,  0,   0,  0,  0,
  /* y=3 */   0,  0,  0,   0,  0,  0, 255,255,255, 255,255,255, 255,255,255, 255,255,255, 255,255,255,   0,  0,  0,   0,  0,  0, 255,255,255, 255,255,255, 255,255,255, 255,255,255, 255,255,255,   0,  0,  0,   0,  0,  0,
  /* y=4 */   0,  0,  0,   0,  0,  0,   0,  0,  0,   0,  0,  0,   0,  0,  0,   0,  0,  0,   0,  0,  0,   0,  0,  0,   0,  0,  0,   0,  0,  0,   0,  0,  0,   0,  0,  0,   0,  0,  0,   0,  0,  0,   0,  0,  0,   0,  0,  0,
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
};

const ExprFrame expr_look_lr_anim[] = {
  { expr_look_lr_f0, 500 },
  { expr_look_lr_f1, 500 },
  { expr_look_lr_f2, 300 },
  { expr_look_lr_f3, 500 },
  { expr_look_lr_f4, 500 }
};
#define EXPR_LOOK_LR_FRAME_COUNT 5
