orbierobot/orbierobot-firmware/(commit log)

2026-06-16 added sound, motors, laser.
2026-09-21 Make the console usable and gate the USB PHY kill behind a dev flag
    Two things stopped this firmware from ever reporting what it was doing.
    First, the primary console is UART0, whose TX is GPIO43 - and app_main()
    drives GPIO43 LOW in the pin-grounding pass that stops the motor driver
    sinking current at boot. Logs went into a grounded pin. USB Serial/JTAG was
    only configured as the *secondary* console, which carries early ROM output but
    not ESP_LOGx, so idf.py monitor showed nothing at all, forever. sdkconfig.dev
    moves the primary console onto USB Serial/JTAG.
    Second, app_main() disables the USB PHY about 2s into boot, because floating
    D+/D- lines trigger USB_UART_CHIP_RESET every ~5s on ba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
2026-09-21 Add Orbie's spoken boot greeting and four RGB eye animations
    The greeting replaces the placeholder PCM in boot_sound.c with a line spoken
    in Orbie's own cloned voice: "Hi there, I'm Orbie, your little robot
    companion. It's really lovely to meet you." 7.92s of 16kHz mono, generated
    from the stored Fish model 496ea6bb94244ec0a8b557baf96c3550 and verified as
    that voice rather than a referenceless speaker (f0 median 310Hz, inside the
    clone's 290-336Hz band; referenceless output measures 105-291Hz). Levelled to
    -1 dBFS peak with no clipped samples. The audio path already existed, so this
    is a data swap: it plays from the existing task, in parallel with the face.
    The animations are red heart, yel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
    [boot_sound.h, led_display.c, led_display.h]
2026-09-21 Add captive-portal Wi-Fi provisioning, and authenticate OTA
    The robot could only ever run its own AP. It can now join the user's network:
    the phone connects to ORBIE_XXXX, the setup page appears by itself, and the
    chosen credentials are saved to NVS and reconnected on every later boot.
    Wi-Fi moves to APSTA so the control UI and camera stream stay reachable
    throughout setup.
    The auto-popup needs two pieces. A DNS server on :53 resolves every name to
    192.168.4.1, and the OS connectivity probes (iOS, Android, Windows, Firefox)
    are answered with a redirect to the portal, with a 404 catch-all covering any
    probe URL not listed. Only A queries are answered with an address: replying to
    AAAA with fo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
    [app_main.cpp, wifi_portal.c, wifi_portal.h]
2026-09-21 Support hidden networks, and say why a join actually failed
    Hidden networks could not be selected at all: the dropdown only offered what
    the scan returned, and a hidden AP by definition is not in it. The list now
    ends with "Other (hidden network)..." which reveals a field for the exact
    name. That field is also the way out when a scan fails outright - previously
    that left the user staring at "Scan failed" with no path forward.
    Joining one needed a firmware change too. A hidden AP puts no SSID in its
    beacons, so it is only found by a directed probe on the right channel, and
    ESP-IDF's default fast scan stops at the first beacon match and can miss it.
    The STA now sweeps every channel and picks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
    [wifi_portal.c]
2026-09-21 Hand over from the portal to the controls once Wi-Fi is up
    The portal was a dead end: after a successful join it showed the IP and
    stopped, leaving the user on a setup page with no way to the robot. It now
    shows an "Open Orbie controls" button and redirects to the control UI - camera
    feed, joysticks, stop/beep/laser - after a short pause.
    It also prints the robot's address on the joined network. Until provisioning,
    the robot is only reachable by joining its own AP; afterwards it is on the
    user's LAN and drivable from any device there, but nothing was saying so.
    The redirect goes to the real control page rather than embedding the stream in
    the portal, because the captive sheet is a cut-down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
    [app_main.cpp, wifi_portal.c]
2026-09-23 Remember up to five Wi-Fi networks, and stop asking once connected
    A robot moves between a desk, a home and a venue, so it now keeps the last
    five networks, most-recently-used first, and tries each in turn at boot. Two
    attempts and 20s each rather than the old five retries: with five stored
    networks the previous behaviour would take over a minute to conclude that none
    of them are in range, with the owner watching a robot do nothing.
    Three fixes behind that, each of which cost real debugging time:
    Changing the NVS key layout orphaned credentials that were already stored. The
    data was never lost, just invisible to the new code, and the robot reported "no
    stored networks" for a network it had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
    [wifi_portal.c]
2026-09-23 Rebuild the control panel, and make the robot safe to leave running
    The panel moves out of app_main.cpp into control_page.h - it had become a few
    hundred characters per line of unreadable string literal wedged between the
    HTTP handlers - and gains a Test section with one button per subsystem: voice,
    beep, eyes, head, motors, laser. Each runs in its own task and reports back,
    because doing them inline would block the HTTP worker for seconds (the eye reel
    alone is ~7s) and the browser would sit on a spinner. Test voice plays the real
    greeting rather than a tone, since the question being asked is "how loud will
    it be when it introduces itself", which a beep does not answer.
    Three hardware prob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
2026-09-23 Add the robot's half of push-to-talk
    Polls /api/pending for a spoken answer and pushes a camera frame to
    /api/frame, so questions about what Orbie can see have something recent to work
    with.
    A poll rather than a push, because the robot sits behind the owner's NAT with
    no inbound route, and holding a socket open from an ESP32 costs a task and
    reconnects badly on flaky Wi-Fi. Two seconds is the compromise: fast enough
    that an answer does not feel stale, slow enough that a robot left running all
    day is not hitting a serverless function forty thousand times an hour.
    The answer is streamed straight to I2S as it arrives rather than buffered. A
    20-second reply is 640KB of PCM - it would not fit i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
    [voice_link.c, voice_link.h]
2026-09-23 Show the firmware version on the face, the portal and the control panel
    An OTA that silently does not take is indistinguishable from one that worked:
    the robot reboots either way and behaves identically. The version is now
    visible in three places, so the answer is immediate and needs no cable.
    On the face it renders in a 3x5 pixel font for ~1.8s before the boot animation.
    Digits only, dots dropped - "1.0.0" shows as 100 and "1.0.1" as 101. Four
    characters is all a 16x8 face fits, and keeping the separators would truncate
    "1.0.1" to "1.0", identical to 1.0.0 and therefore useless for the one job this
    exists to do.
    The glyphs are written into a logical frame and handed to
    display_draw_rgb_fr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
    [app_main.cpp, control_page.h, led_display.c, led_display.h, wifi_portal.c]
2026-09-23 Move the face animations into the control panel, and add text to speech
    Boot went straight from power-on into a wakeup animation, a blink, a look
    around and the full demo reel - about twelve seconds of show, performed once,
    to nobody, while the robot was still starting up. It now shows its version and
    settles on the neutral face, and all of that lives in the panel where it can be
    triggered on cue.
    A Face section gives one icon per expression: heart, star, rainbow, thinking,
    blink, bliss, wake and neutral. /expr?show=<name> runs each in its own task,
    because the reel is several seconds and would otherwise block the HTTP worker.
    A Speak section adds four preset lines and a free-text box. The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
2026-09-23 Fix the portal's way out, and drop the boot colour beacons
    "Open the controls" pointed at the robot's address on the owner's network.
    Whoever reads that page joined ORBIE_xxxx to get there, so they are on a
    different subnet and cannot route to it - the button silently did nothing. It
    now points at the AP address, with the LAN address shown separately as the way
    back in from their own network later.
    The captive sheet also has no address bar, so being handed a URL to type is no
    help. There are now four ways through: the button, a target=_blank link that
    usually escapes the sheet on iOS, a copy button, and the address itself marked
    user-select:all so one tap selects it.
    The boot beacons are g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
    [app_main.cpp, wifi_portal.c]
2026-09-23 Make OTA work, and stop one bad chip from hiding the rest
    OTA had never once succeeded. esp_http_server listens on PF_INET6 whenever
    CONFIG_LWIP_IPV6 is set, which it is by default, so getsockname() hands back
    a sockaddr_in6 and every IPv4 client arrives IPv4-mapped. The "is this
    request local?" check read that through a sockaddr_in, landing on
    sin6_flowinfo instead of the address, so the subnet test compared against
    zero and refused everything - including uploads from the robot's own AP,
    the one path it was written to allow. Read it through a sockaddr_storage
    and handle both families.
    The upload then still died around 45s under load, because the receive loop
    treated HTTPD_SOCK_ERR_TIMEOUT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
2026-09-23 Add BLE provisioning, and stop giving up on Wi-Fi
    The app sets up Wi-Fi over Bluetooth, so the owner never has to join the
    robot's own AP first. The NimBLE GATT service is ported from the v3 firmware;
    it called into that tree's wifi_manager, and the three operations it needs -
    set credentials, read the IP, scan - already existed inside wifi_portal, so
    they are exposed directly rather than reimplemented. It lives in main/ because
    it needs wifi_portal.h, and a component depending on main would be circular.
    It advertises as "Orbie-XXYY" to match the app's name filter. The captive
    portal stays exactly as it was, for anyone without the app.
    Three bugs found while testing it against the phone: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
    [app_main.cpp, ble_prov.c, ble_prov.h, voice_link.c, voice_link.h, wifi_portal.c, wifi_portal.h]
2026-09-23 Stop a phone joining the AP from crashing the robot
    The control server ran on esp_http_server's default 4096-byte stack while the
    portal's hand-off page built a ~2.6KB response in a stack buffer. A phone
    joining ORBIE_xxxx hits the captive-portal probe URLs immediately, that
    handler runs, and the stack overflowed - the robot rebooted within seconds of
    any phone connecting to it, which looked like instability in everything else
    being worked on at the time. 8KB now, and the page buffer is static.
    Wi-Fi scanning, which the app triggers over BLE on every connect, was the
    other half of that: it swept all 13 channels with the default dwell, long
    enough to drop the very link it was scanning from.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
    [app_main.cpp, ble_prov.c, voice_link.c, voice_link.h, wifi_portal.c]
2026-09-24 Add rollback and factory reset, so a bad update is not a dead robot
    Two failures leave a robot unusable but still running, and both were
    unrecoverable without a cable:
    - A bad update. The partition table has been dual-slot with rollback enabled
    all along, and the previous image sits there intact - there was simply no
    way to ask for it. POST /ota/rollback switches back, and refuses when the
    other slot holds nothing bootable rather than rebooting into a brick.
    - Wrong Wi-Fi credentials, or a device key that no longer matches the server.
    POST /factory-reset erases NVS - networks, key, API base, volume - and
    restarts on the same firmware, opening its own AP to be set up again.
    A robo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
    [app_main.cpp]
2026-09-24 Stop the cloud retry loop draining the socket pool; report why
    The robot became unusable a few minutes after every boot: accept() returned
    ENFILE, the control page and camera stopped answering, and TLS could not
    allocate. It read like a memory fault or a bad CA bundle. It was neither -
    the certificate verifies fine. voice_link retried an unreachable cloud every
    2s forever, and each attempt took a socket from a pool of 16 that the two
    HTTP servers had already mostly claimed, leaving it in TIME_WAIT afterwards.
    Failures now back off to a minute, and frames are not pushed at a server we
    cannot reach. Steady state is unchanged: while calls succeed the interval
    stays at 2s. E508's internal-DRAM l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
    [app_main.cpp, voice_link.c]
2026-09-24 Halve the TLS input buffer and free it between handshakes
    cloud_online was false on both robots: the certificate verified, then the
    handshake died on allocation and sockets started failing with ENFILE. The
    cause was internal DRAM, not certificates - mbedtls takes its buffers from
    internal memory, the input buffer defaulted to 16KB per connection, and it
    was held for the life of the connection. On this board the camera
    framebuffers, two HTTP servers and TLS compete for roughly 300KB of internal
    DRAM, and the low-water mark reached 51 bytes.
    8KB still covers the records this API sends, and MBEDTLS_DYNAMIC_BUFFER
    releases the buffer between handshakes rather than holding it. Both robots
    now re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
2026-09-25 Let the robot hand back the device key it already holds
    Server registration is first-come, so a robot claimed by an earlier install
    refuses a second one with 409. Reinstalling the app therefore left it with no
    key and push-to-talk permanently inert, recoverable only with the admin key
    and a hand-edit of the app's storage - which is exactly what happened last
    night, and again this morning when the app vanished from the tablet.
    The robot has had the key in NVS the whole time. GET /api/key returns it, so
    the app heals itself on a fresh install. This is the same LAN-only server
    that already drives the motors and streams the camera to any caller, so it
    exposes nothing that was not already availa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
2026-09-25 Allocate mbedtls from PSRAM instead of internal DRAM
    Measuring first: this was never a leak. free_internal swung between 2.6KB and
    31KB and recovered every time, so nothing was being lost - the robot simply
    lived a few kilobytes above empty, and a TLS handshake that landed on a low
    point failed. That is why cloud_online flickered rather than staying false,
    and why E508 degraded overnight while 73B4 did not: 73B4's camera is dead, so
    it never allocates framebuffers and never gets near the floor.
    mbedtls buffers are not DMA, so they have no business in internal memory when
    there are megabytes of PSRAM going spare. With them moved out, free_internal
    on E508 went from 2.6-15KB to a steady 32-44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
2026-09-25 Report reset reason and uptime in /status
    Under load the robot came back with its minimum-free-heap counter reset,
    which only happens on boot - so it had rebooted, silently, and there was no
    way afterwards to tell a panic from a brownout from a watchdog because the
    console scrollback was long gone. /status now carries esp_reset_reason() and
    uptime, so a reboot is visible in the same poll that shows the symptoms and
    a power problem cannot masquerade as a software one.
    [app_main.cpp]
2026-09-25 Release the speaker after a spoken answer
    ptt_play_done() existed but nothing ever called it, so the first queued
    answer took the audio mutex on its opening chunk and held it for the rest of
    the boot. Everything afterwards - another answer, /say, even a beep - failed
    with "Speaker unavailable or busy" while the console showed no playback at
    all, because nothing was playing: the lock was simply never given back. In a
    demo that means the first question is answered out loud and every one after
    it is met with silence.
    voice_link now signals the end of a clip, at both the queued-answer and the
    speak paths, and the player releases the speaker there. It also tracks
    whether it actually holds the mu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
    [app_main.cpp, voice_link.c, voice_link.h]
2026-09-29 Point at Orbie's own API, and stop accepting firmware from the LAN
    Two changes that belong in one flash, because after the second one there is no
    way to do another over the network.
    API_BASE_DEFAULT moves to the new deployment. This only matters to a robot that
    has never been told otherwise - both bench units already carry the new base in
    NVS - but a unit flashed from source should not come up pointing at an account
    we are migrating off.
    The LAN OTA allowance is gone. It was always marked NOT for shipping: it let
    any device on the owner's network reflash the robot behind a MAC-derived token,
    which is fine on a bench and not fine in someone's home. Updates are now
    accepted only from the rob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
2026-10-01 Add V5 electronics review package (body, pogo, dock, feeder, water boards)
    Five KiCad 10 boards generated from gen_v5.py, autorouted, ERC/DRC clean,
    with gerbers/stencil layers, pick-and-place, BOM and a 22-page review PDF.
    Body board rev 0.2 applies the 26 Sep 2026 hardware requirements (cliff
    sensors, bumper, motor current sense, 3x VL53L5CX, I2C buffer, amp gain
    strap, DW01A pack protection, NTC interlock, reset/boot buttons, lidar
    port, USB TVS). Dock base keeps its pads dead until a robot is present and
    runs the feeder without the robot; feeder/water are dumb modules on a
    10-pin stacking bus.
    Open: body outline must be confirmed against the body (the March STEP has
    no 79.5x94.62 Main P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
    [orbie_v5_body.kicad_pcb, orbie_v5_body.kicad_sch, orbie_v5_body_bom.csv, orbie_v5_body_bom_jlc.csv, orbie_v5_dock.kicad_pcb, orbie_v5_dock.kicad_sch, orbie_v5_dock_bom.csv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]
